laurencebarker/Aries-ATU/hardware/rev 5/rev 5 PCB modification 2.png

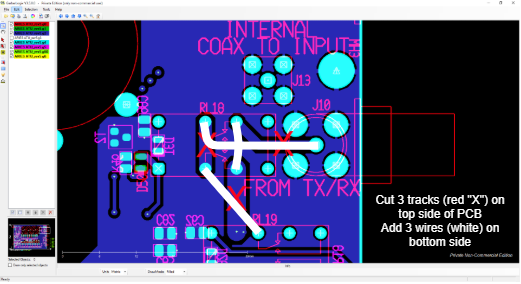
hardware/rev 5/rev 5 PCB modification 2.png
