laurencebarker/Aries-ATU/pictures/20201004_124850.jpg

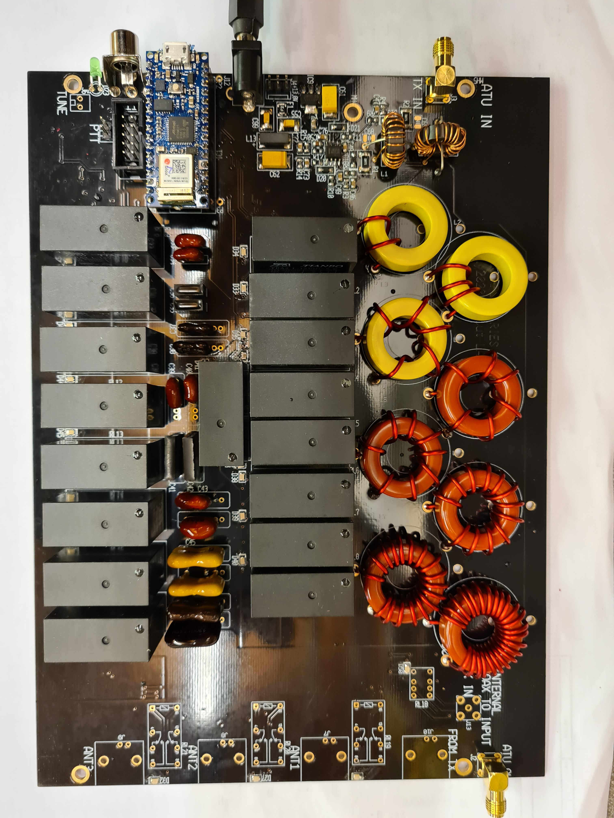
pictures/20201004_124850.jpg
