laurencebarker/Aries-ATU/README.md

# Aries ATU
 ARIES ATU for HPSDR project
