laurencebarker/Aries-ATU/documentation/Binocular core VSWR bridge.png

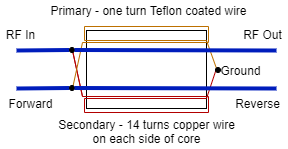
documentation/Binocular core VSWR bridge.png
