laurencebarker/Aries-ATU/hardware/rev 5/rev 5 PCB modification 1.png

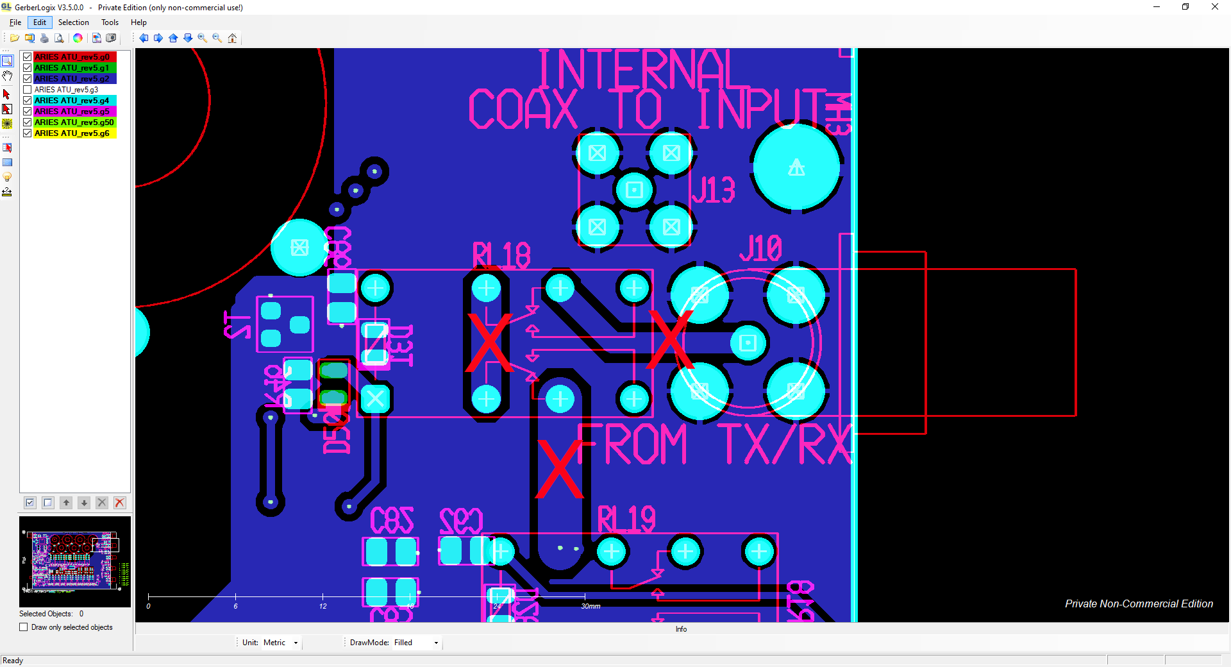
hardware/rev 5/rev 5 PCB modification 1.png
