laurencebarker/Aries-ATU/nextion display/crossed needle 200.png

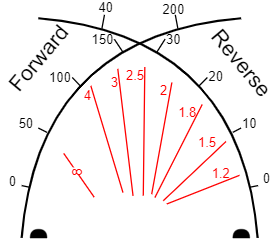
nextion display/crossed needle 200.png
