laurencebarker/Aries-ATU/nextion display/crossed needle-2000W.png

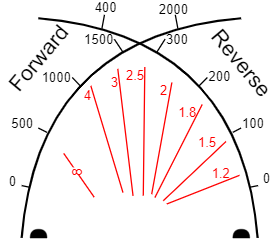
nextion display/crossed needle-2000W.png
