laurencebarker/Aries-ATU/nextion display/linear power meter-analogue meter 100.png

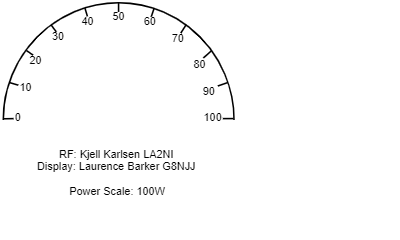
nextion display/linear power meter-analogue meter 100.png
