laurencebarker/Aries-ATU/nextion display/linear power meter-Analogue Meter 2000.png

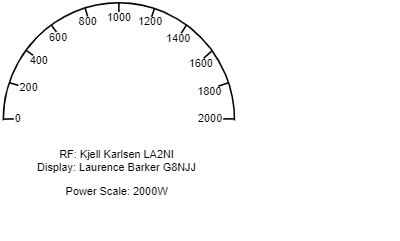
nextion display/linear power meter-Analogue Meter 2000.png
