laurencebarker/Aries-ATU/hardware/rev 5/Aries parts list rev 5.xlsx

Sheet: Embedded ATU
Qty | reference | type | part number | RS stock number
17 | RL1-RL17 | Relay | TIANBO TRA2 L-12VDC-S-Z | n/a
1 | IC1 | Arduino | Nano 33 IoT | n/a
2 | IC2, 3, 7 | Shift register | TPIC6B595 | 662-9203
1 | IC4 | op Amp | LM358BIDR SOIC | 689-6719
1 | IC5 | logic | 74HCT04D SOIC | 112-9988
1 | IC6 | regulator | LM1117S33CTR SOT223 | 197-7198
1 | IC8 | EEPROM | 24FC1026-I/SN SOIC | 823-3270
1 | IC9 | regulator | LM1117-5 SOT-223 | 535-8641
22 | D1-D17, D24-26, D51, D52 | diode | BAS16J 0805
4 | D18-21 | diode | IN5711W-7-F SOD-80_W
17 | D33-49 | LED | 0805 red | 654-5818
1 | D23 | LED | 3mm leaded green
52 | C1-C32, C46-49, C59-C60, C64-C67, C70- C76, C88, C90-91 | capacitor | 10nF 0805 50Vceramic
2 | C33-C34 | capacitor | 20pF mica
2 | C35-C36 | capacitor | 39pF mica
2 | C37-C38 | capacitor | 82pF mica
2 | C39-C40 | capacitor | 180pF mica
2 | C41-C42 | capacitor | 330pF mica
2 | C43-C44 | capacitor | 680pF mica
2 | C45, C56 | capacitor | 1300pF mica
2 | C57-C58 | capacitor | 2700pF mica
2 | C50, C51 | capacitor | 1uF 0805 25V ceramic
1 | C62 | capacitor | 100uF 10V tantalum 7.5x4.5mm
1 | C61 | capacitor | 15uF 35V tantalum 7.5x4.5mm
5 | C53, C55, C99, C101, C102 | capacitor | 10uF 0805 25V ceramic
5 | C63, C77, C89, C98, C100 | capacitor | 100nF 0805 50V ceramic
6 | R1, R2, R41-R44 | resistor | 100R 0.75W 2010 (5025M) | 198-8501
2 | R3, R4 | resistor | 100K 0805
10 | R5-R7, R22, R24, R25, R26, R45, R47, R48 | resistor | 10K 0805
3 | R8, R9, R23 | resistor | 1K 0805
2 | R10, R11 | resistor | 220K 0805
2 | R12, R13 | resistor | Dependent on full scale power required For 100W: 2K7 For 200W: 4K7 F0r 500W: 8K2 For 1000W: 12K For 2000W: 18K
2 | R14, R15 | resistor | 1K8 0805 (for all power scales)
17 | R19-21, R27-40 | resistor | 2K7 0805
1 | F1 | fuse | polysilicon 2.1A 1206 | 817-1668
2 | L3-L4 | toroid | T94-6
4 | L4-L8 | toroid | T94-2
1 | L9, L11 | toroid | BN-61-202
3 | L10, L12, L13 | ferrite bead | Fair-rite 2743021447 | 467-3365
2 | L19-L20 | ferrite bead | 0805
2 | J2, J3 | SMA rt angle |  | 616-3400 | DNI
2 | J14, J16 | BNC rt angle | TYCO 5-1634556-0 | 616-3084
1 | J12 | connector | 2.1mm 12V power | 448-376
1 | J4 | connector | 3 pin 0.1" pitch header
1 | J11 | connector | phono PCB mtg
1 | J1 | connector | header 2x5 pin 0.1" pitch |  | DNI
2 | J15, J18 | connector | header 4 pin 0.1" pitch
1 | J19 | connector | header 5 pin 0.1" pitch
3 | J5, J6, J17 | connector | header 2 pin 0.1" pitch |  | DNI
1 | L22 | wire | jumper pin 1-2
DNI=do not insert this component!
Inductor windings:
L1 | 2T 18SWG wound on 6.5mm drill bit, 0.15" length
L2 | 3T 18SWG wound on 6.5mm drill bit, 0.2" length
L3 | T94-6 (yellow) | 4T 18 SWG
L4 | T94-6 (yellow) | 5T 18 SWG
L5 | T94-2 (red) | 7T 18 SWG
L6 | T94-2 (red) | 9T 18SWG
L7 | T94-2 (red) | 13T 18SWG
L8 | T94-2 (red) | 19T 18SWG
VSWR bridge | BN-61-202 | primary: 1T 22 SWG through centre
 |  | secondary: 14T 26 SWG wound around the sides of the core
SK17 | add a jumper on SK17 for "standalone" ATU mode
The VSWR bridge is now a binocular core using a BN-61-202 core, 14 turns

Sheet: Standalone ATU
Qty | reference | type | part number | RS stock number
2 | J14, J16 |  |  |  | DNI
2 | L14-15 | ferrite bead | Fair-rite 2743021447 | 467-3365
3 | L16-L18 | ferrite bead | 0805 size, 100 ohm@10MHz
2 | J2, J13 | SMA vert
4 | J7-J10 | BNC rt angle |  | 616-3084
4 | D28-D31 | Diode | BAS16J 0805
11 | C54, C79, C84, C86, C87, C92-97 | capacitor | 10nF 0805 50Vceramic
6 | C78, C80-83, C85 | capacitor | 100nF 0805 ceramic
1 | T2 | FET | 2N7002K-T/R
4 | R16-18, R46 | Resistor | 2K7 0603
4 | RL18-21 | Relay | Omron G6A-274P | Mouser 653-G6A-274P-DC12
4 | D22, D27, D32, D50 | LED | red 0805
1 | J2-J3 | Cable | SMA-SMA
These components are in addition to those loaded for embedded use in the Andromeda radio
