laurencebarker/Aries-ATU/hardware/protection board/protection board parts list.xlsx

Protection Board
Qty | reference | type | part number | RS stock number
 | R6, R7, R8, R18,R19, R20, R22 | 1K 0603
 | R5, R21, R23 | 10K 0603
 | R1, R2, R3, R4, R9, R10, R11, R16, R17 | 2K2 0603
 | R24 | 22K 0603
 | R12, R13, R14, R15 | 1K potentiometer
 | C1, C2, C5, C6, C8, C12, C13, C14, C16, C17, C18, C19, C20, C21, C22, C23 | 100nF 0805
 | C4, C7, C9, C10 | 1uF 0805
 | C3, C11 | 10uF 0805
1 | D1 | bAS16J
6 | D2-D7 | S1M
2 | T1, T2 | 2N7002A
1 | U1 | LM339
1 | IC1 | MCP23017
1 | U2 | 74HC02SO
1 | U3 | 74HC21SO
1 | U4 | LM1117-3V3
1 | ENC1 | Encoder
