laurencebarker/Aries-ATU/documentation/atu toroids.xlsx

Sheet: 1st prototype
 |  | T80-6 |  | T80-10 |  | T80-2 |  | T68-2 |  | T68-6
 | target inductance | turns | actual | turns | actual | turns | actual | turns | actual | turns | actual
L1 | 0.04 | 3 | 0.04 | 4 | 0.05 | 3 | 0.05 |  |  | 3 | 0.04
L2 | 0.08 | 4 | 0.07 | 5 | 0.08 | 4 | 0.09 |  |  | 4 | 0.08
L3 | 0.16 | 6 | 0.16 | 7 | 0.16 | 0.14 | 5 |  |  | 6 | 0.17
L4 | 0.32 | 8 | 0.29 | 10 | 0.32 | 0.35 | 8 |  |  | 8 | 0.3
L5 | 0.64 | 12 | 0.65 | 14 | 0.63 | 0.67 | 11 |  |  | 12 | 0.68
L6 | 1.28 | 17 | 1.3 | 20 | 1.28 | 1.24 | 15 | 15 | 1.28
L7 | 2.56 | 24 | 2.59 | 28 | 2.51 | 2.66 | 22 | 21 | 2.51
L8 | 5.12 | 34 | 5.2 | 40 | 5.12 | 5.29 | 31 | 30 | 5.13
 | power handling?
 | AT11 values | T106-2
 | target inductance | turns | actual
 | 0.08 | 1 | 0.01
 | 0.16 | 2 | 0.05
 | 0.31 | 3 | 0.12
 | 0.62 | 4 | 0.22
 | 1.25 | 7 | 0.66
 | 2.5 | 11 | 1.63
 | 5 | 17 | 3.9
 | 10 | 25 | 8.44
 | www.changpuak.ch
Capacitors
comp | value (pF) | total value (pF)
C33, C34 | 18 | 9
C35, C36 | 39 | 19.5
C38, C38 | 82 | 41
C39, C40 | 150 | 75
C41, C42 | 330 | 165
C43, C44 | 680 | 340
C45, C56 | 1500 | 750
C57, C58 | 3300 | 1650

Sheet: Revised
target inductance uH | Toroid | Al | Calc Turns | Actual turns | Achieved inductance uH | Measured inductance uH
0.04 | T68-2 | 57 | 2.6 | 1 | 0.006
0.08 | T68-2 | 57 | 3.7 | 2 | 0.02
0.18 | T68-2 | 57 | 5.6 | 4 | 0.09
0.312 | T106-2 | 135 | 4.8 | 4 | 0.22
0.625 | T106-2 | 135 | 6.8 | 6 | 0.49
1.25 | T106-2 | 135 | 9.6 | 9 | 1.09
2.5 | T106-2 | 135 | 13.6 | 13 | 2.28
5 | T106-2 | 135 | 19.2 | 19 | 4.87
Toroid | Al
T50-2 | 49
T50-6 | 40
T68-2 | 57
T68-6 | 47
T80-2 | 55
T80-6 | 45
T94-2 | 84
T94-6 | 70
T106-2 | 135
T106-6 | 116
Capacitors
comp | value (pF) | total value (pF)
C33, C34 | 18 | 9
C35, C36 | 39 | 19.5
C38, C38 | 82 | 41
C39, C40 | 150 | 75
C41, C42 | 330 | 165
C43, C44 | 680 | 340
C45, C56 | 1500 | 750
C57, C58 | 3300 | 1650

Sheet: prototype 2 revised again
target inductance uH | Toroid | Al | Calc Turns | Actual turns | Achieved inductance uH
0.023 | T94-6 | 70 | 1.8 | 1 | 0.007 | try 2T 0.3" dia 0.15" length
0.047 | T94-6 | 70 | 2.6 | 2 | 0.03 | try 3T 0.3" dia 0.2" length
0.094 | T94-6 | 70 | 3.7 | 4 | 0.11
0.188 | T94-6 | 70 | 5.2 | 5 | 0.17
0.375 | T94-2 | 84 | 6.7 | 7 | 0.41
0.75 | T94-2 | 84 | 9.4 | 9 | 0.68
1.5 | T94-2 | 84 | 13.4 | 13 | 1.42
3 | T94-2 | 84 | 18.9 | 19 | 3.03
Toroid | Al
T50-2 | 49
T50-6 | 40
T68-2 | 57
T68-6 | 47
T80-2 | 55
T80-6 | 45
T94-2 | 84
T94-6 | 70
T106-2 | 135
T106-6 | 116
Capacitors
component | Target | value (pF) | combined value (pF)
C33, C34 | 21.1 | 20 | 10 | non-E12
C35, C36 | 42.2 | 39 | 19.5
C38, C38 | 84.4 | 82 | 41
C39, C40 | 168.8 | 180 | 90
C41, C42 | 337.5 | 330 | 165
C43, C44 | 675 | 680 | 340
C45, C56 | 1350 | 1300 | 650 | non-E12
C57, C58 | 2700 | 2700 | 1350

Sheet: prototype 2
target inductance uH | Toroid | Al | Calc Turns | Actual turns | Achieved inductance uH
0.04 | T94-6 | 70 | 2.4 | 2 | 0.028
0.08 | T94-6 | 70 | 3.4 | 3 | 0.06
0.18 | T94-6 | 70 | 5.1 | 5 | 0.17
0.312 | T94-2 | 84 | 6.1 | 6 | 0.30
0.625 | T94-2 | 84 | 8.6 | 8 | 0.54
1.25 | T94-2 | 84 | 12.2 | 12 | 1.21
2.5 | T94-2 | 84 | 17.3 | 17 | 2.43
5 | T94-2 | 84 | 24.4 | 24 | 4.84
Toroid | Al
T50-2 | 49
T50-6 | 40
T68-2 | 57
T68-6 | 47
T80-2 | 55
T80-6 | 45
T94-2 | 84
T94-6 | 70
T106-2 | 135
T106-6 | 116
Capacitors
comp | value (pF) | total value (pF)
C33, C34 | 18 | 9
C35, C36 | 39 | 19.5
C38, C38 | 82 | 41
C39, C40 | 150 | 75
C41, C42 | 330 | 165
C43, C44 | 680 | 340
C45, C56 | 1500 | 750
C57, C58 | 3300 | 1650
