laurencebarker/Aries-ATU/measurements/16112020 Aries mk2 tuning solutions.xlsx

Sheet: Tuning Solutions 5uH largest
17 October 2020 Aries mk2 test results. Largest inductor 5uH largest capacitor 1650pF
Frequency | Antenna analyser |  |  |  | algorithm
1.9 MHz | Z sw | L | C | VSWR | Z sw | L | C | VSWR
8:1 Low | L | 29 | 255 | 1.7
5:1 | L | 31 | 240 | 1.4
4:1 | L | 37 | 208 | 1.4
3:1 | L | 39 | 180 | 1.3
2:1 | L | 44 | 128 | 1.3
1:1 | L | 0 | 0 | 1.0
2:1 High | H | 78 | 53 | 1.5
3:1 | H | 128 | 53 | 1.5
4:1 | H | 152 | 46 | 1.5
5:1 | H | 182 | 42 | 1.5
8:1 | H | 255 | 32 | 1.6
Antenna | L | 160 | 71 | 2.4
1st search |  | Lo Z; L=32; C=0-255 step 24
 |  | Lo Z; C=32; L=0-255 step 24 |  |  |  |  |  | TUNED ANTENNA!
 |  | Hi Z; L=32; C=0-255 step 24
 |  | Hi Z; C=32; L=0-255 step 24
2nd search |  | same Z; swap L/C; 0-255 step 24
Frequency | Antenna analyser |  |  |  | algorithm
3.65 MHz | Z sw | L | C | VSWR | Z sw | L | C | VSWR
8:1 Low | L | 5 | 128 | 1.4
5:1 | L | 8 | 127 | 1.3
4:1 | L | 9 | 109 | 1.3
3:1 | L | 16 | 93 | 1.3
2:1 | L | 11 | 64 | 1.3
1:1 | L | 0 | 8 | 1.0
2:1 High | H | 48 | 26 | 1.3
3:1 | H | 64 | 24 | 1.3
4:1 | H | 76 | 19 | 1.3
5:1 | H | 96 | 16 | 1.3
8:1 | H | 120 | 12 | 1.4
Antenna | L | 33 | 138 | 1.4
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
