laurencebarker/Aries-ATU/measurements/24032020 Aries mk1 test results.xlsx

Sheet: VSWR Bridge
Aries VSWR tests
VSWR bridge alone not connected to L/C and relays
 |  | multimeter |  |  | Arduino ADC measurements
Load ohms | expected VSWR | Vf | Vr | Calc VSWR | Vf (ADC) | Vr (ADC) | dig VSWR
12.5 | 4:1 | 0.793 | 0.46 | 3.8 | 998 | 578 | 3.8
16.7 | 3:1 | 0.814 | 0.388 | 2.8 | 1033 | 496 | 2.8
25 | 2:1 | 0.85 | 0.268 | 1.9 | 1083 | 347 | 1.9
50 | 1:1 | 0.939 | 0 | 1.0 | 1199 | 11 | 1.0
100 | 2:1 | 1.057 | 0.315 | 1.8 | 1326 | 400 | 1.9
150 | 3:1 | 1.115 | 0.535 | 2.8 | 1397 | 669 | 2.8
200 | 4:1 | 1.155 | 0.663 | 3.7 | 1447 | 839 | 3.8
VSWR bridge connected to relays and L/C
 |  | multimeter |  |  | Arduino ADC measurements
Load ohms | expected VSWR | Vf | Vr | Calc VSWR | Vf (ADC) | Vr (ADC) | dig VSWR
12.5 | 4:1 | 0.716 | 0.384 | 3.3 | 914 | 493 | 3.3
16.7 | 3:1 | 0.735 | 0.31 | 2.5 | 932 | 396 | 2.5
25 | 2:1 | 0.769 | 0.178 | 1.6 | 975 | 231 | 1.6
50 | 1:1 | 0.853 | 0.086 | 1.2 | 1084 | 113 | 1.2
100 | 2:1 | 0.972 | 0.485 | 3.0 | 1235 | 620 | 3.0
150 | 3:1 | 1.002 | 0.735 | 6.5 | 1315 | 960 | 6.4
200 | 4:1 | 1.088 | 0.884 | 9.7 | 1366 | 1105 | 9.5
VSWR bridge connected to relays and L/C, RL1 issue resolved
 |  | multimeter
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
