laurencebarker/Aries-ATU/documentation/test loads.xlsx

Zo | 50 | ohms
Load |  | Resistance | Made from | qty
8:1 L | 8 | 6.25 | 22R// 18R // 18R | 3
5:1 | 5 | 10 | 22R // 18R | 2
4:1 | 4 | 12.5 | 22R//27R | 2
3:1 | 3 | 16.7 | 33R//33R | 2
2:1 | 2 | 25 | 4x100R parallel | 4
1:1 | 1 | 50 | 100R // 100R | 2
2:1 | 2 | 100 | 180R // 220R | 2
3:1 | 3 | 150 | 330R // 270R | 2
4:1 | 4 | 200 | 100R + 100R | 2
5:1 | 5 | 250 | 100R + 150R | 2
8:1 | 8 | 400 | 270R + 220R | 2
 |  |  |  | 25
resistors needed
18R | 3
22R | 3
27R | 1
33R | 2
100R | 9
150R | 1
180R | 1
220R | 2
270R | 2
330R | 1
 | 25
parallel value calculator
R1 | 33
R2 | 33
parallel | 16.5
