laurencebarker/Aries-ATU/hardware/protection board/PA Protection Board.pdf

- R24 22K

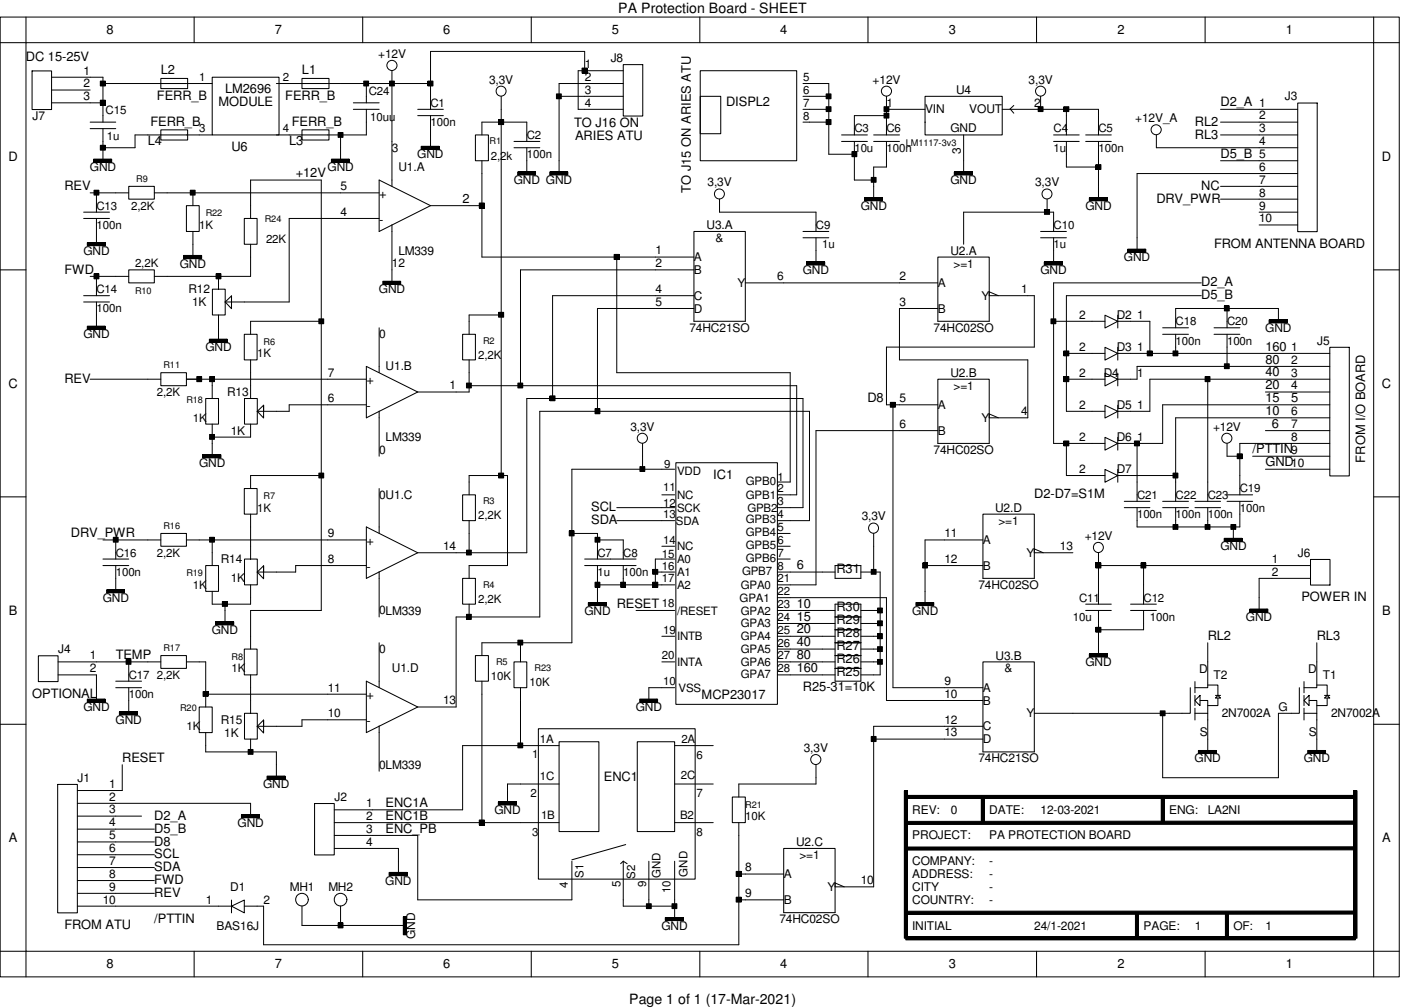
[picture p25: page 1]

PA Protection Board - SHEET

TO J15 ON ARIES ATU TO J16 ON ARIES ATU
