laurencebarker/Aries-ATU/hardware/rev 5/ARIES ATU_rev5_28_01_21.pdf

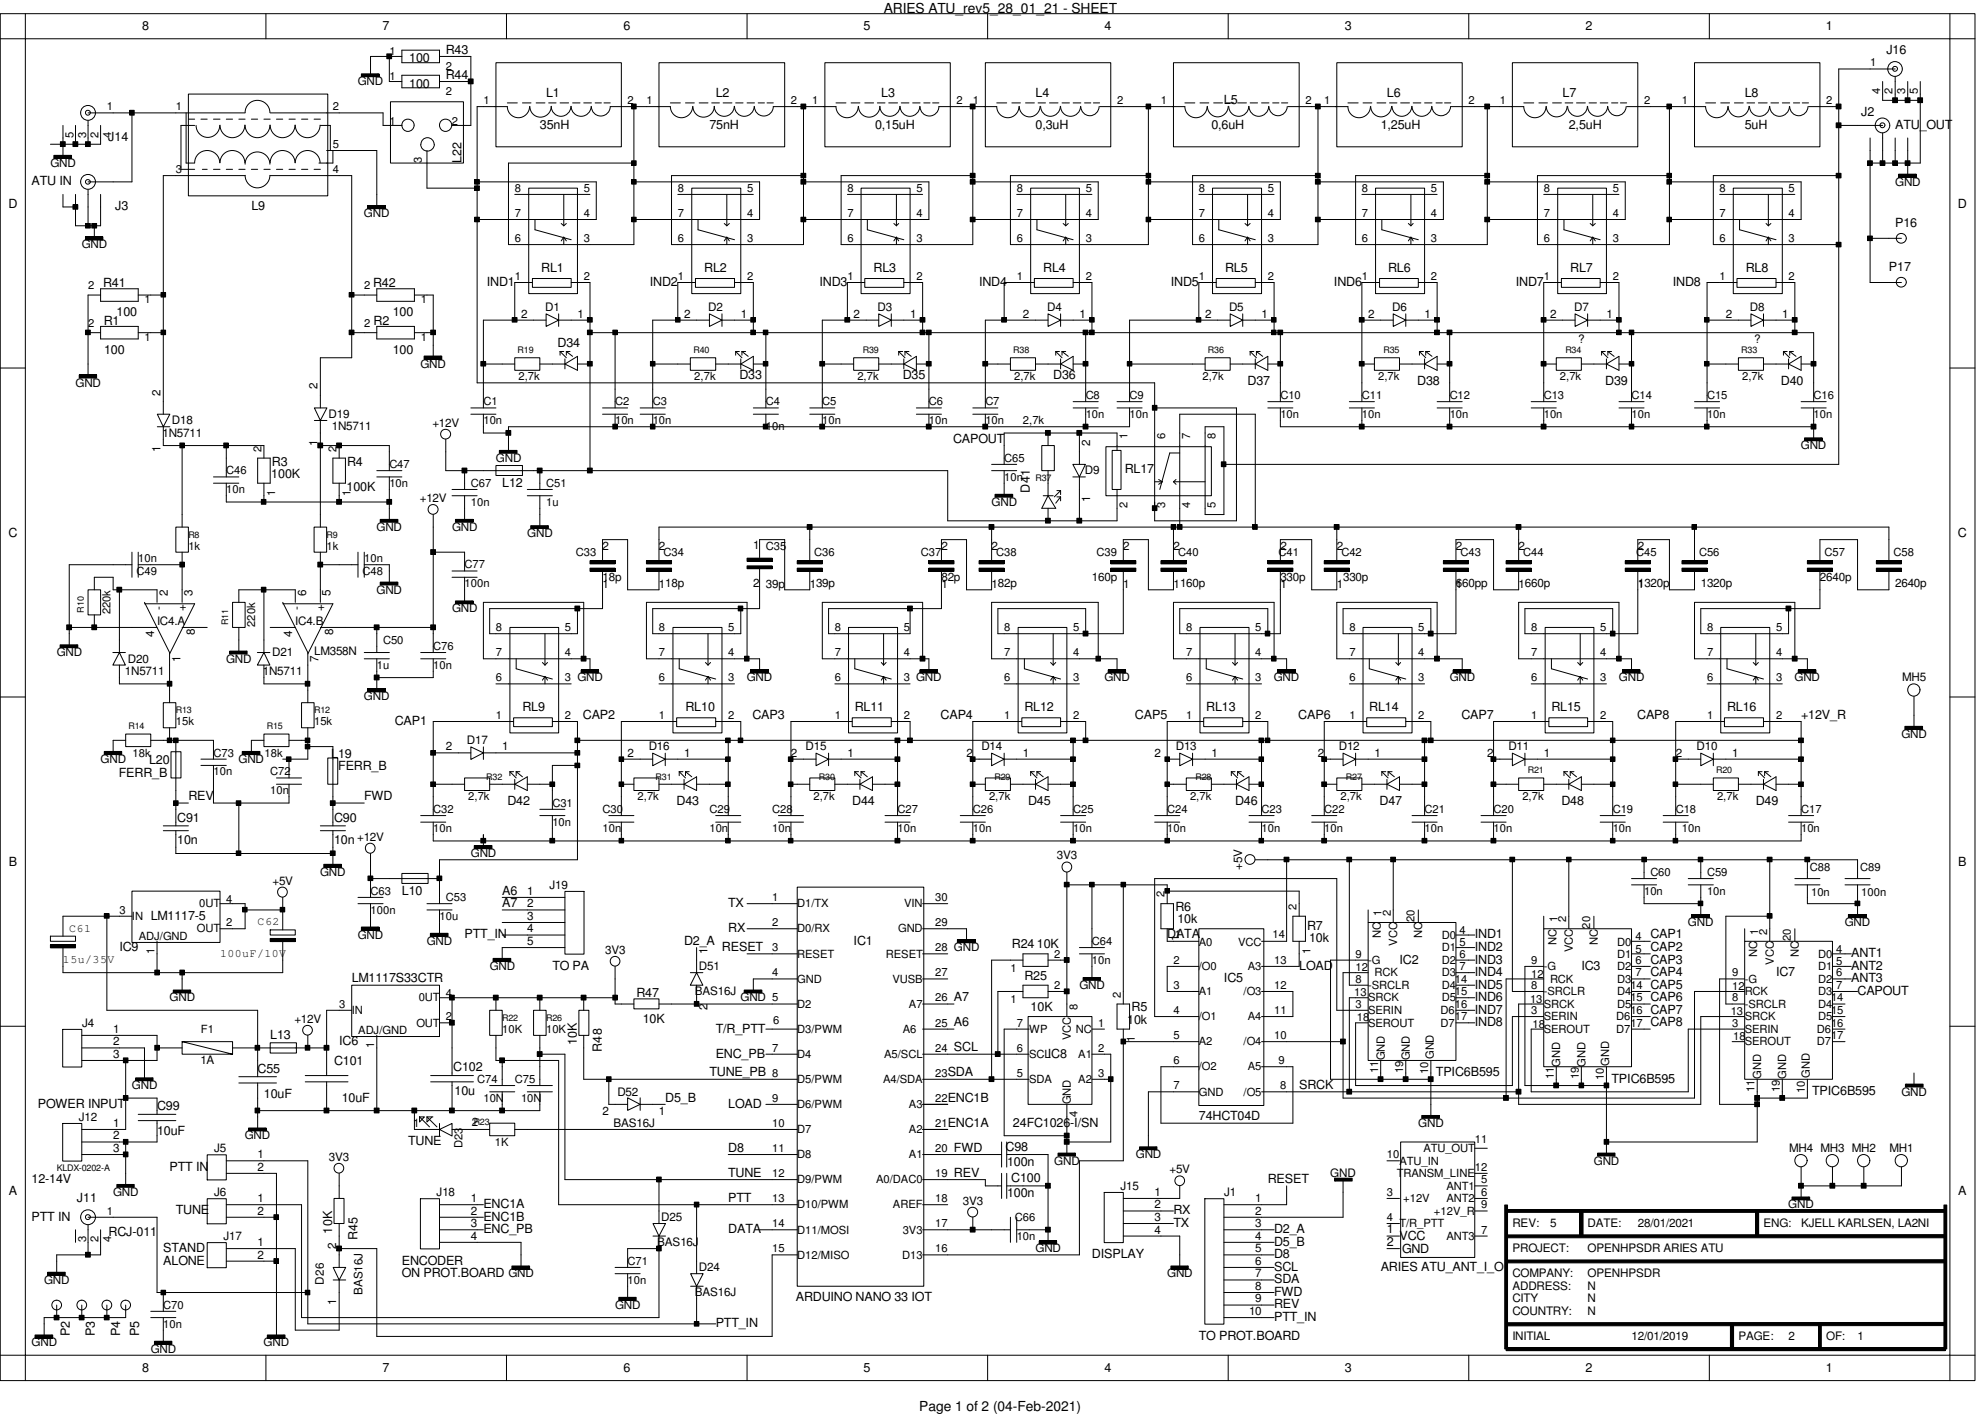
[picture p26: page 1]

# ARIES ATU_rev5_28_01_21 - SHEET

D | D

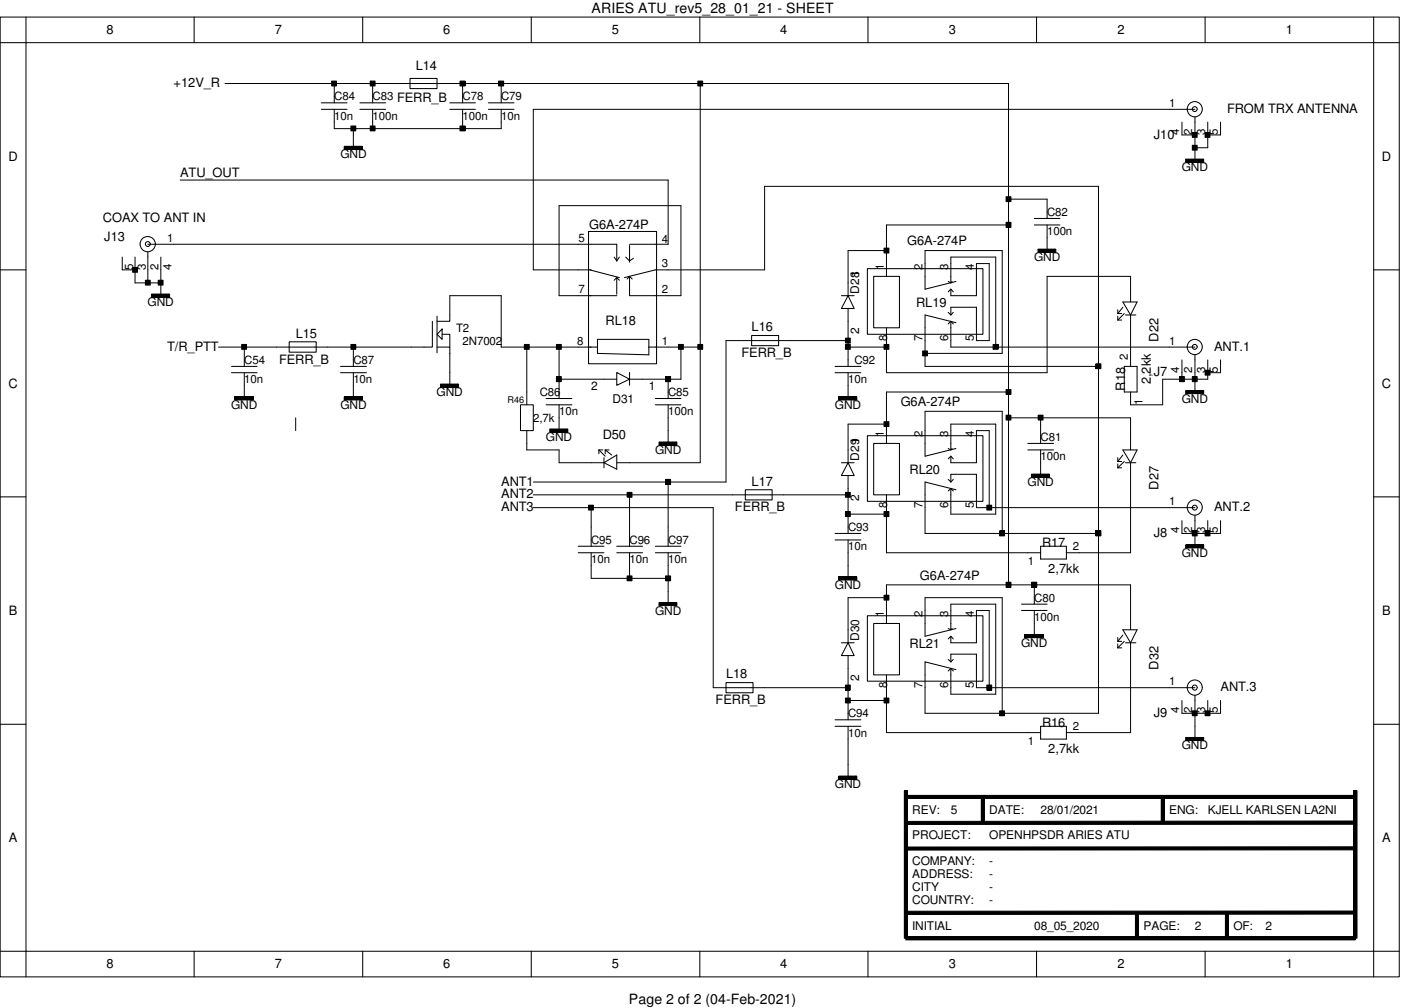
[picture p27: page 2]

COAX TO ANT IN
