laurencebarker/Aries-ATU/hardware/rev 5/ARIES ATU_rev5.pdf

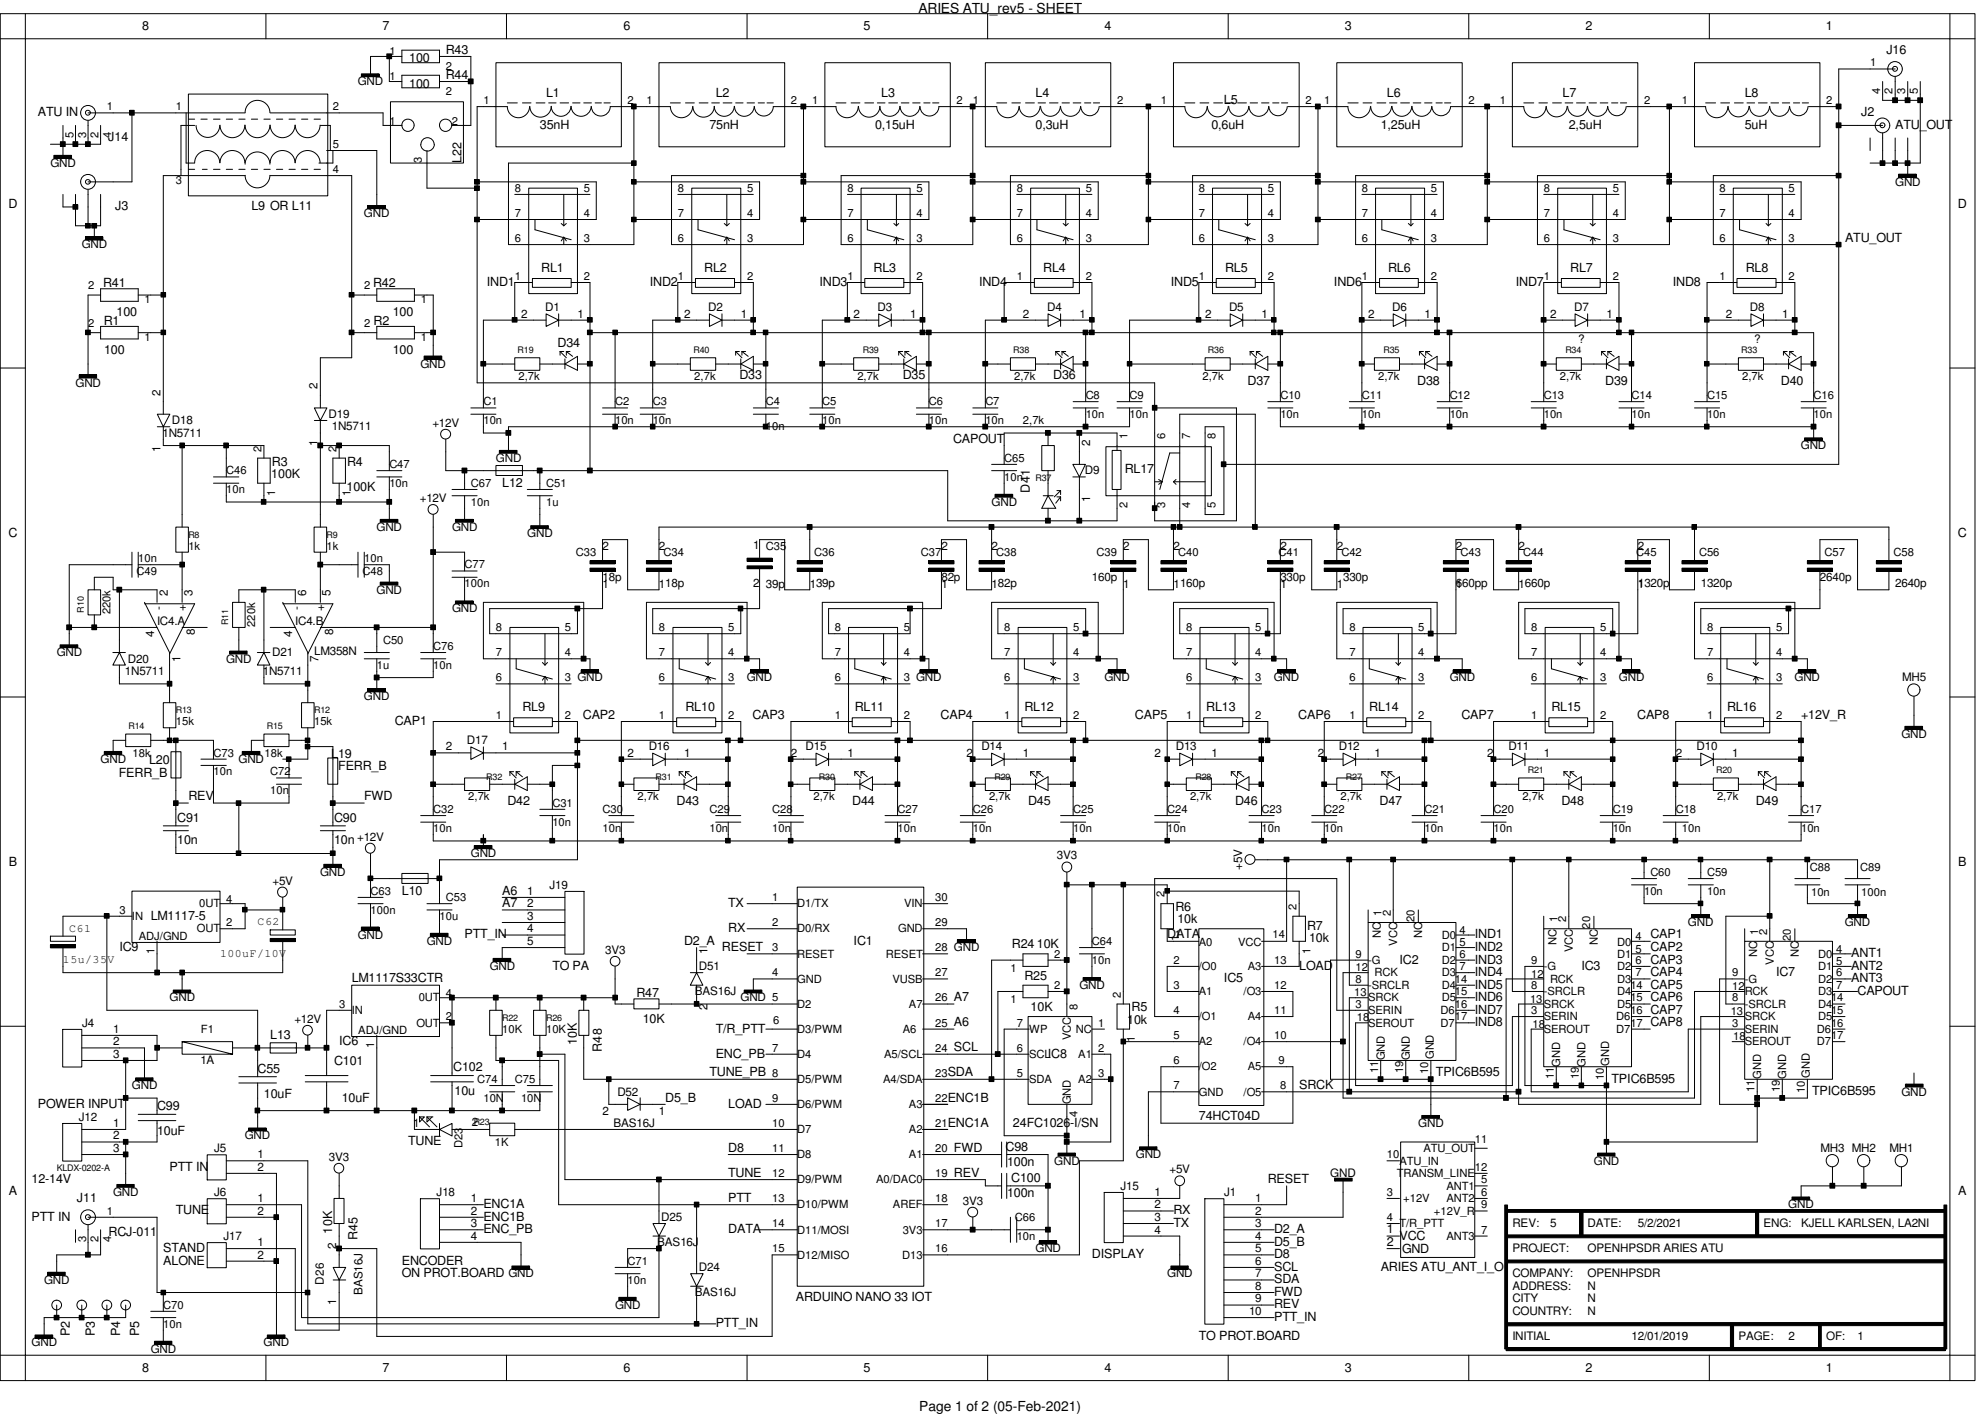
[picture p28: page 1]

# ARIES ATU_rev5 - SHEET

D | D

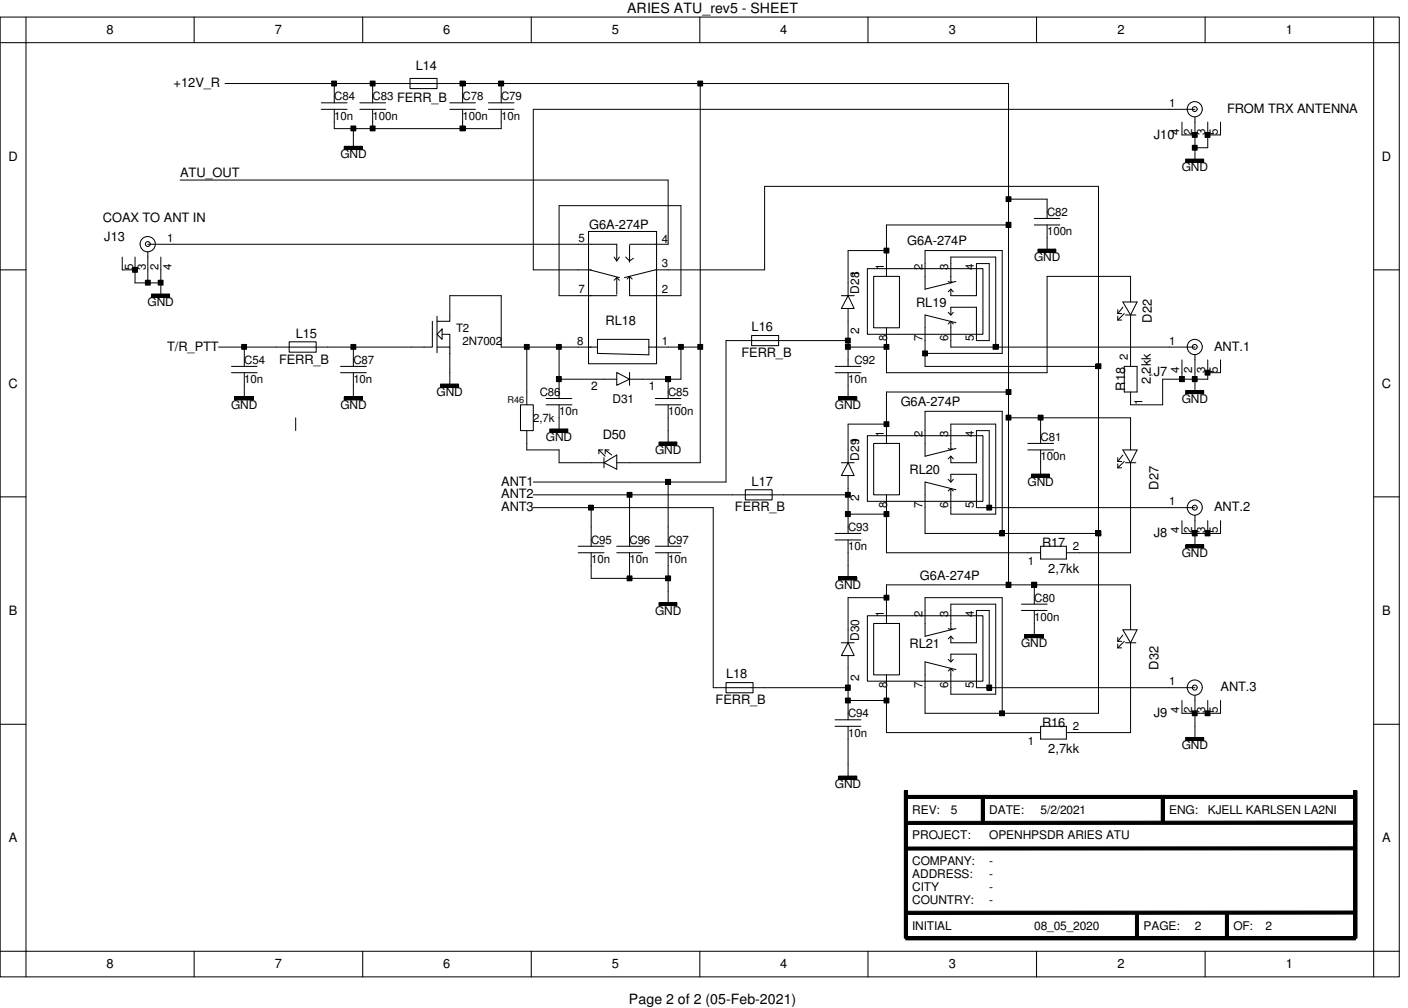
[picture p29: page 2]

COAX TO ANT IN
