laurencebarker/Aries-ATU/hardware/rev 4/ARIES ATU_rev4_18_11_20.pdf

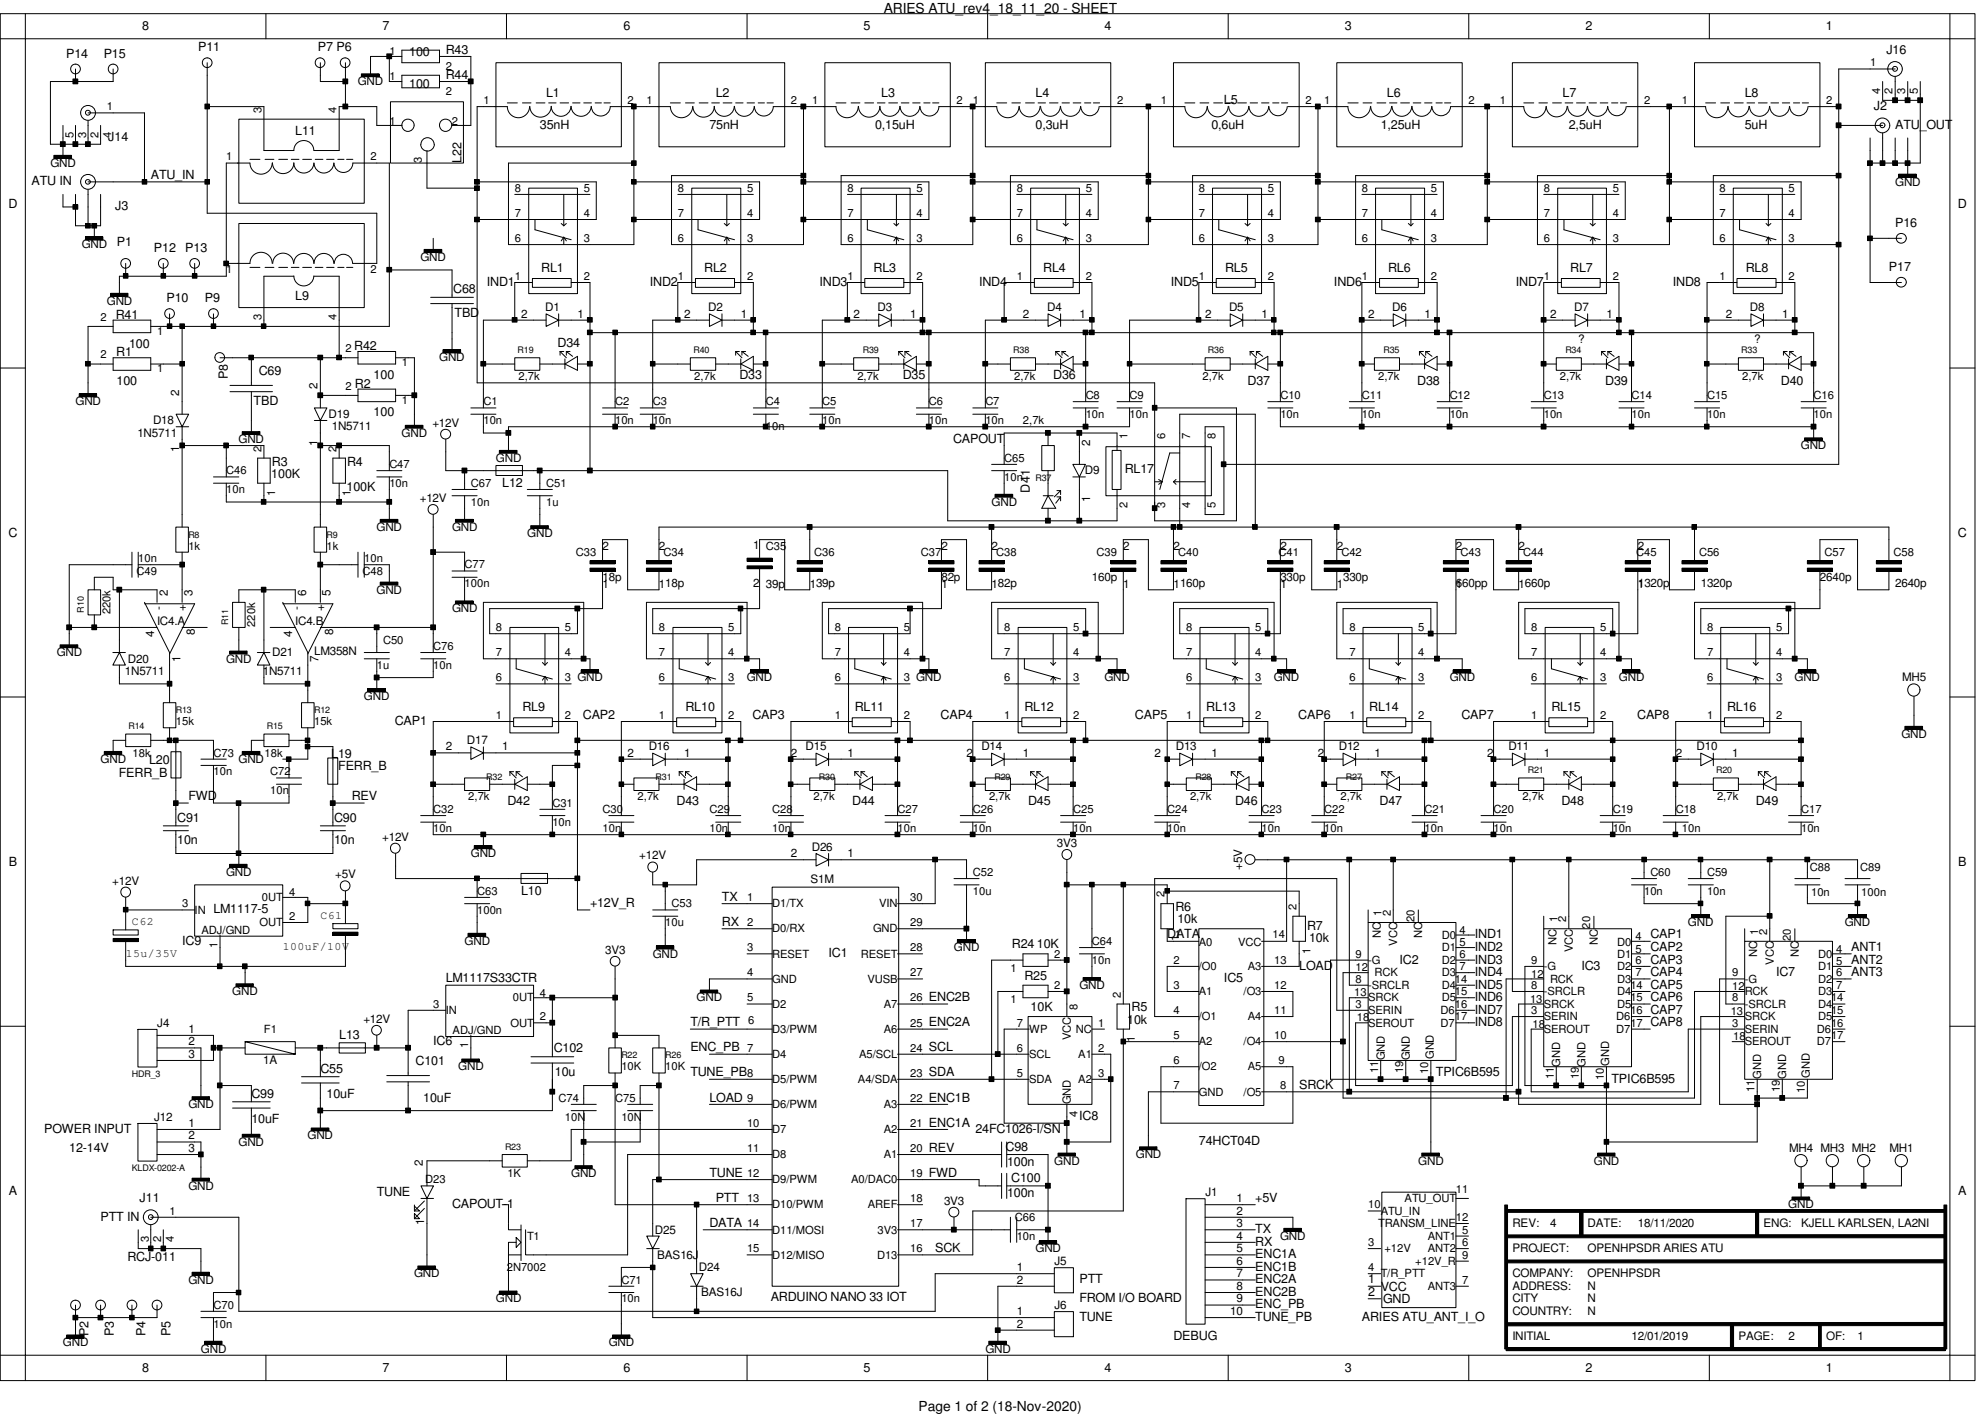
[picture p32: page 1]

INITIAL 12/01/2019 | PAGE: 2 | OF: 1

# ARIES ATU_rev4_18_11_20 - SHEET

D | D

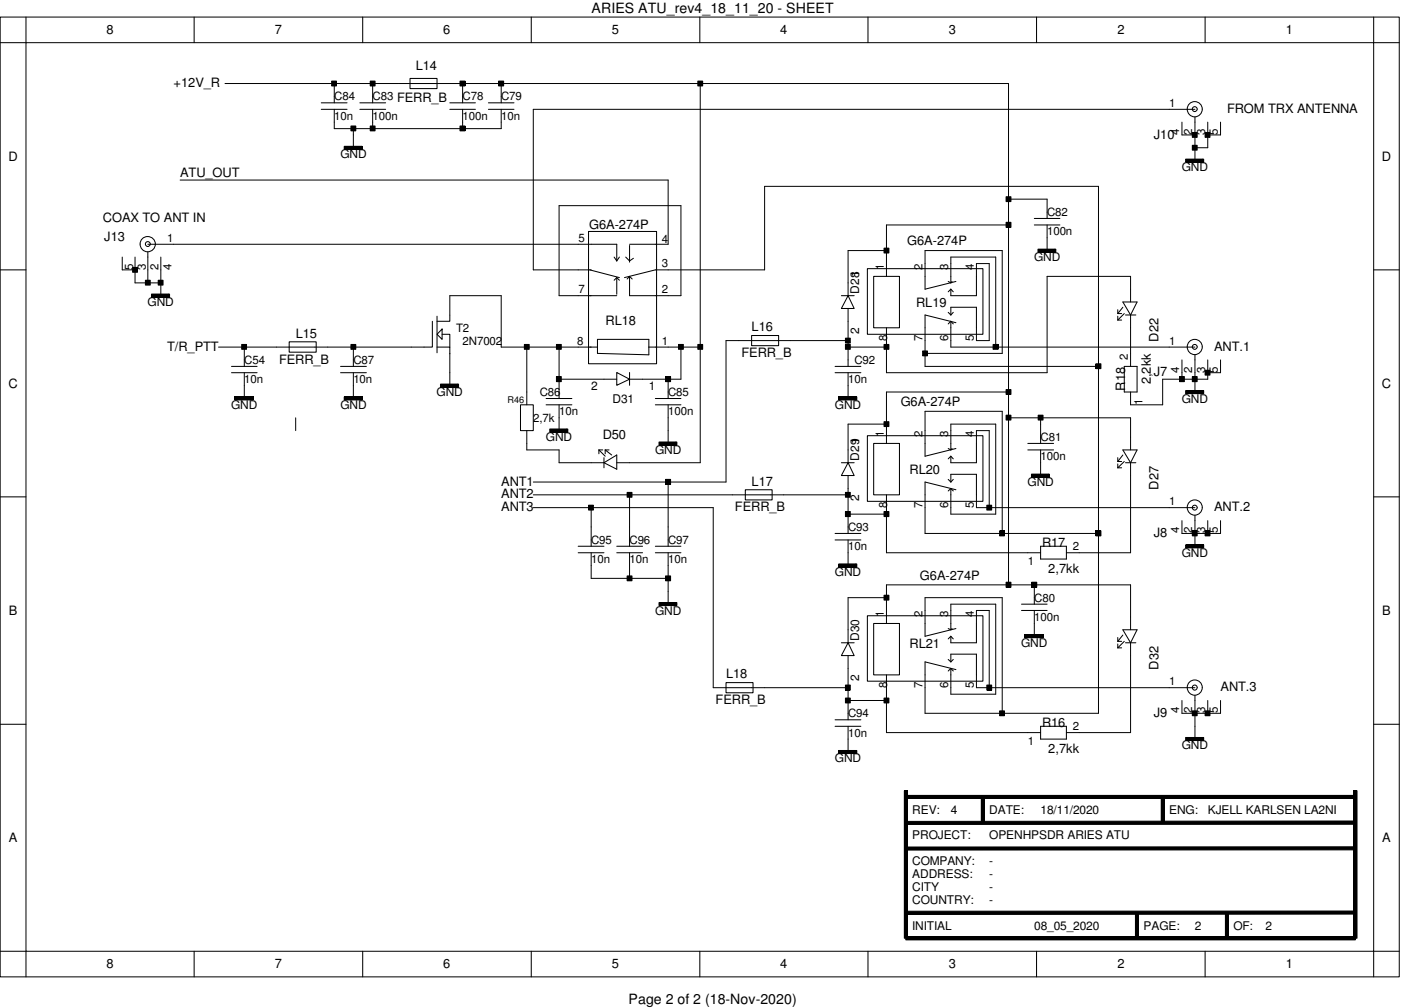
[picture p33: page 2]

COAX TO ANT IN
