laurencebarker/Aries-ATU/hardware/rev 4/ARIES ATU_rev4_20_11_20.pdf

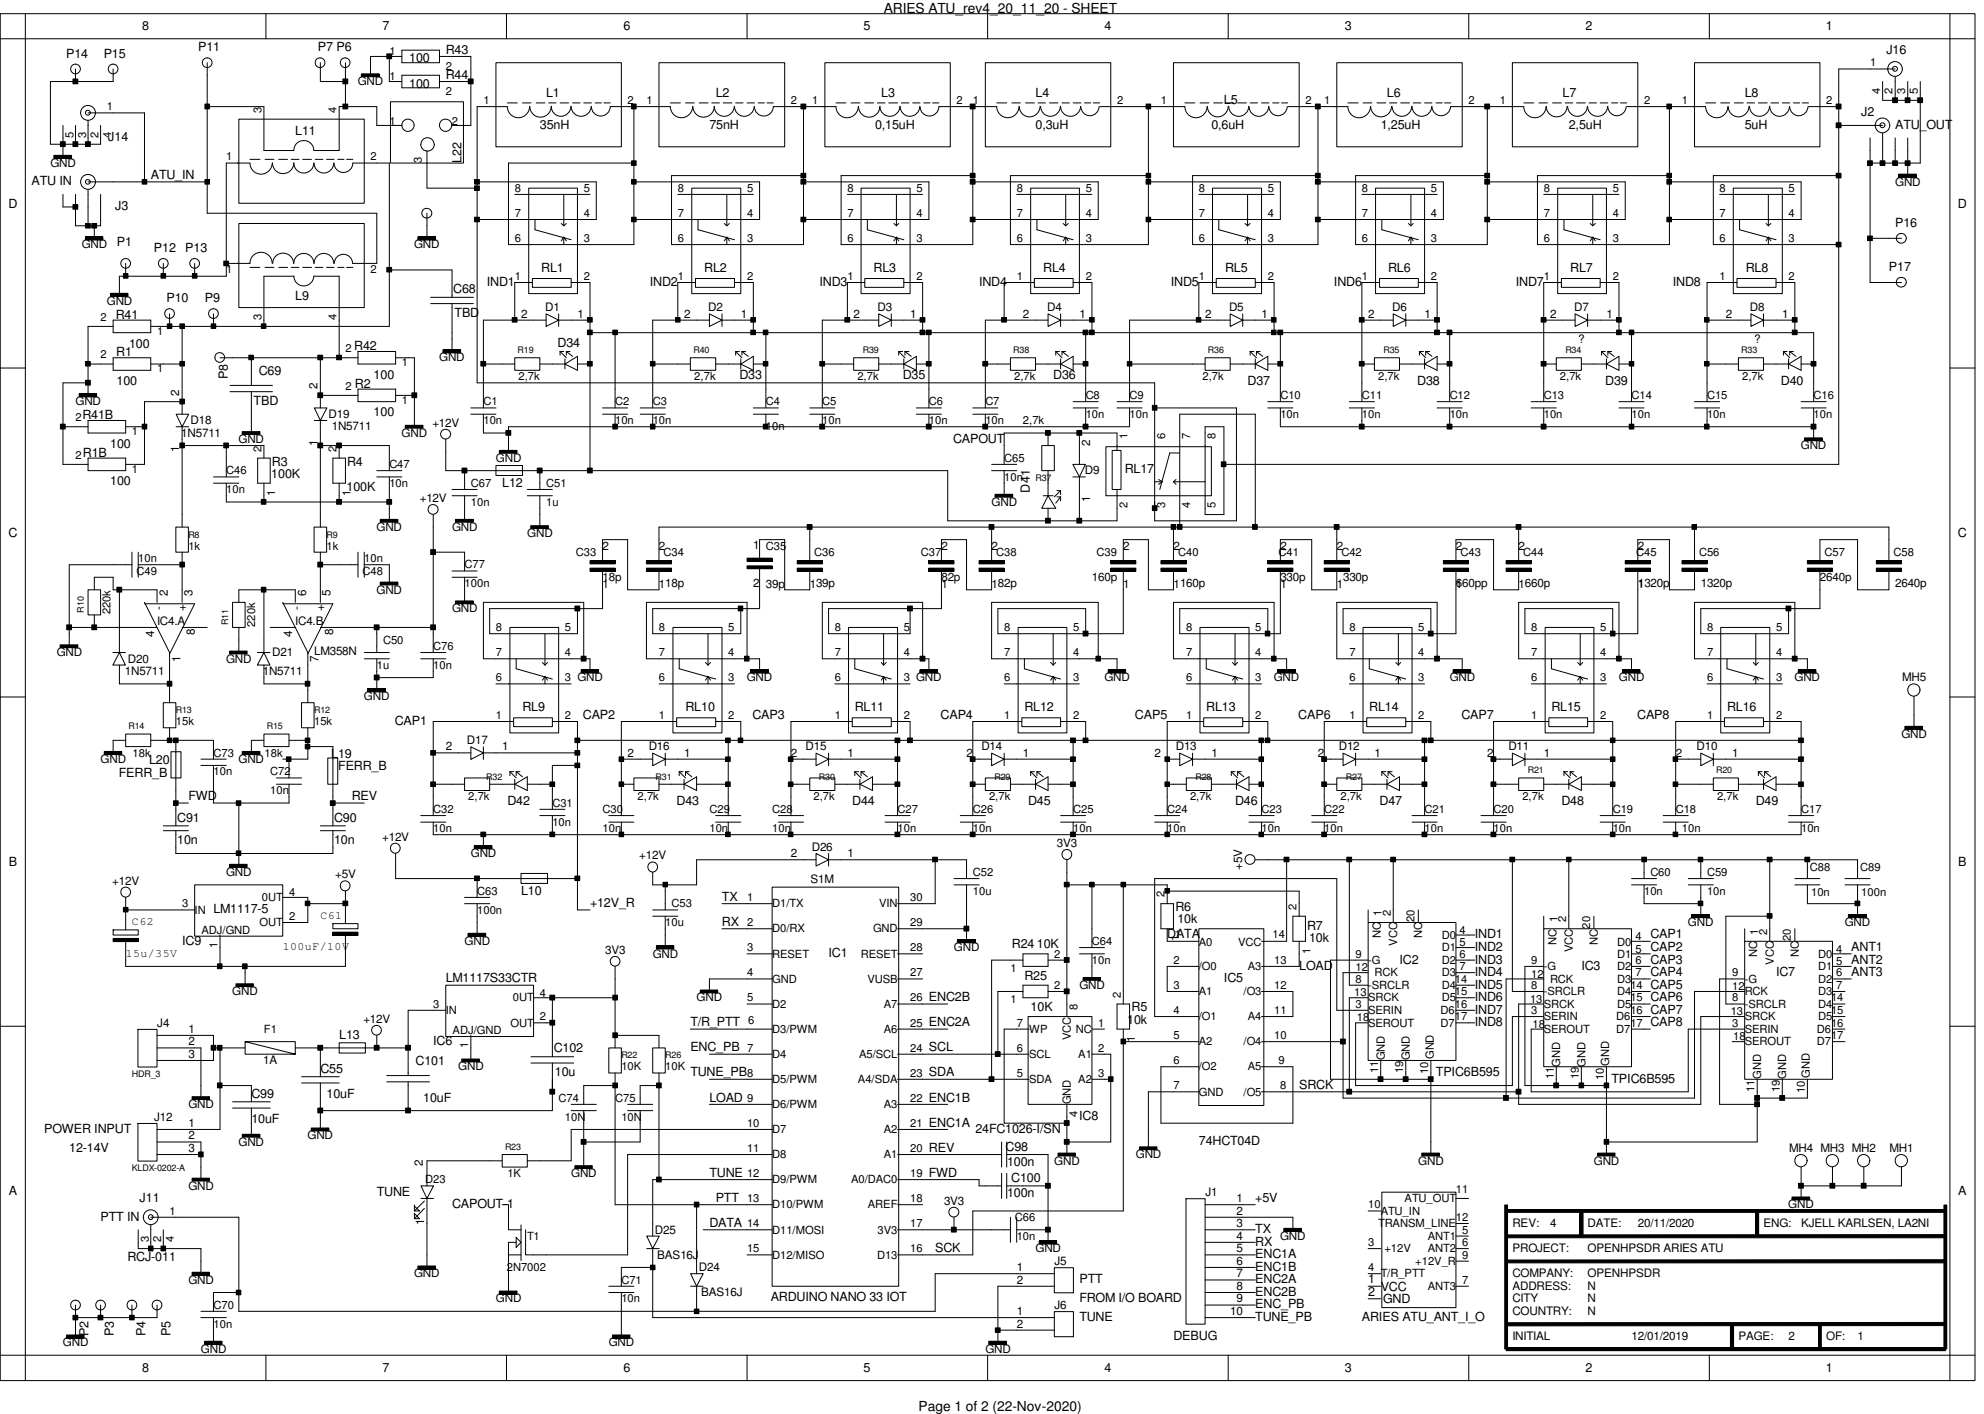
[picture p34: page 1]

INITIAL 12/01/2019 | PAGE: 2 | OF: 1

# ARIES ATU_rev4_20_11_20 - SHEET

D | D

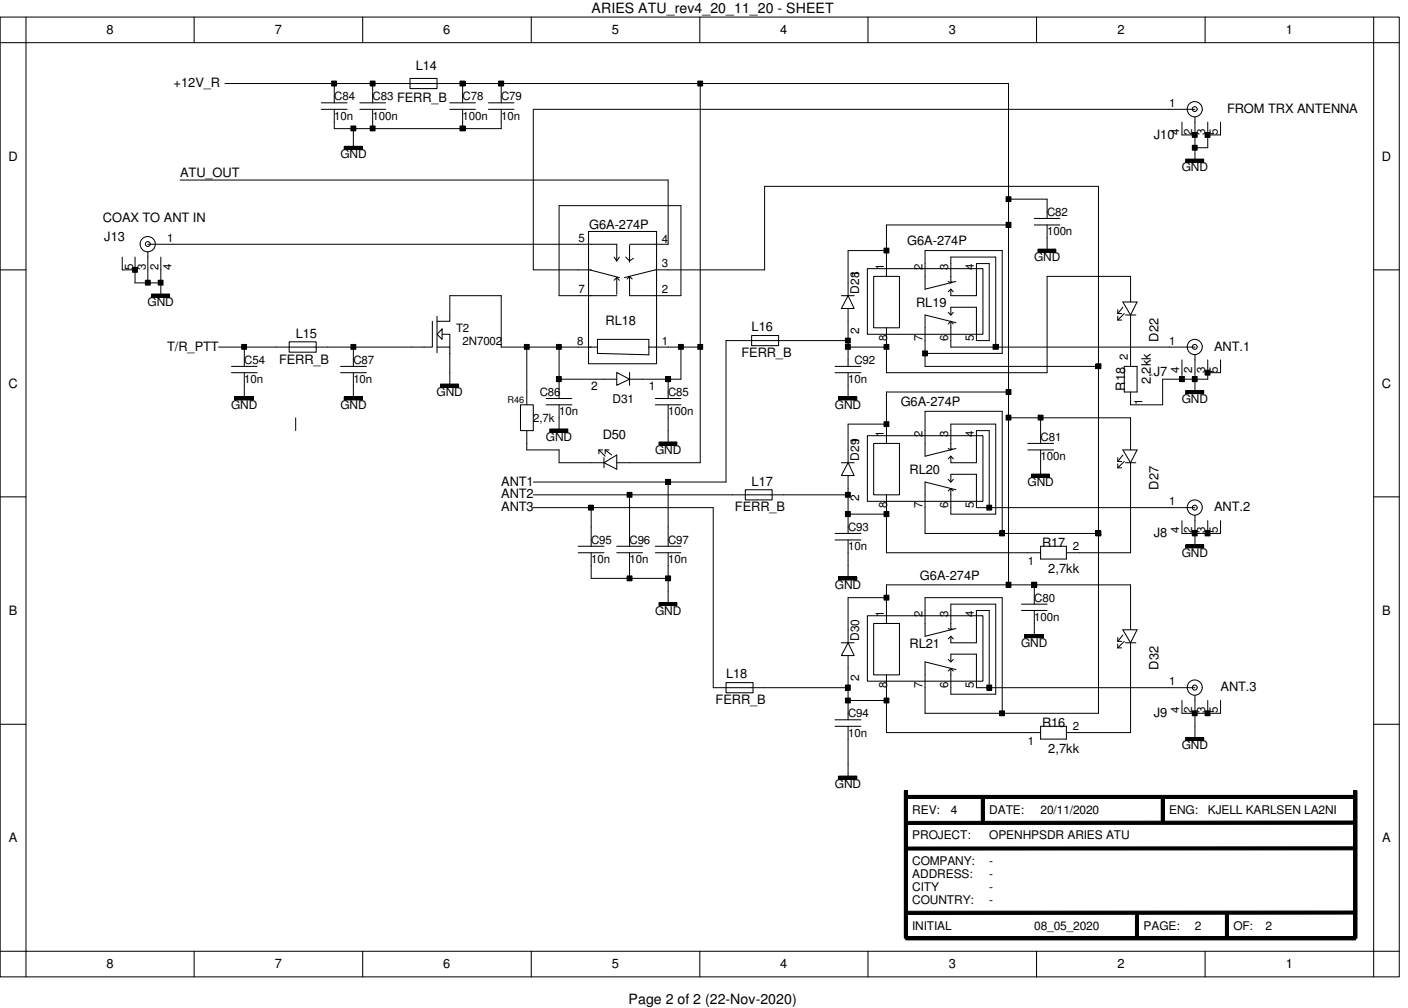
[picture p35: page 2]

COAX TO ANT IN
