laurencebarker/Aries-ATU/hardware/rev 4/ARIES Notation Bott.pdf

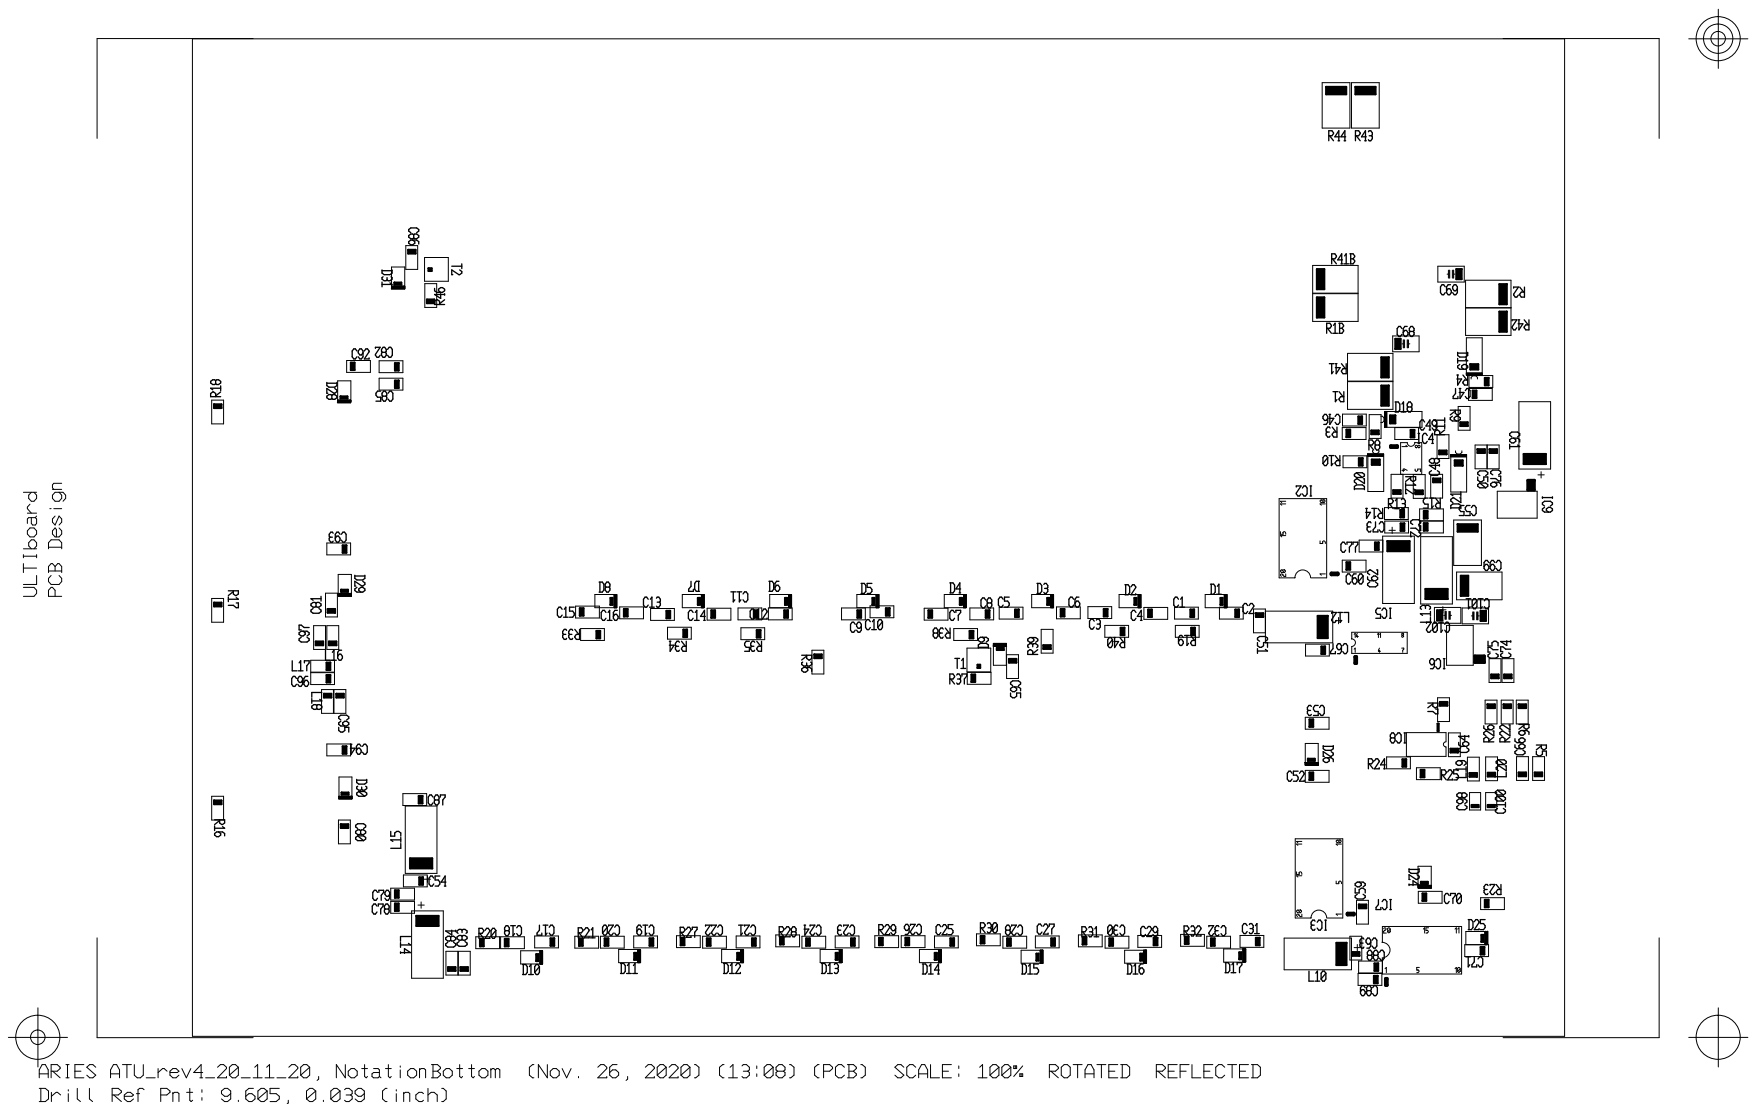
[picture p36: page 1]
