laurencebarker/Aries-ATU/hardware/rev 4/Aries Notation Top.pdf

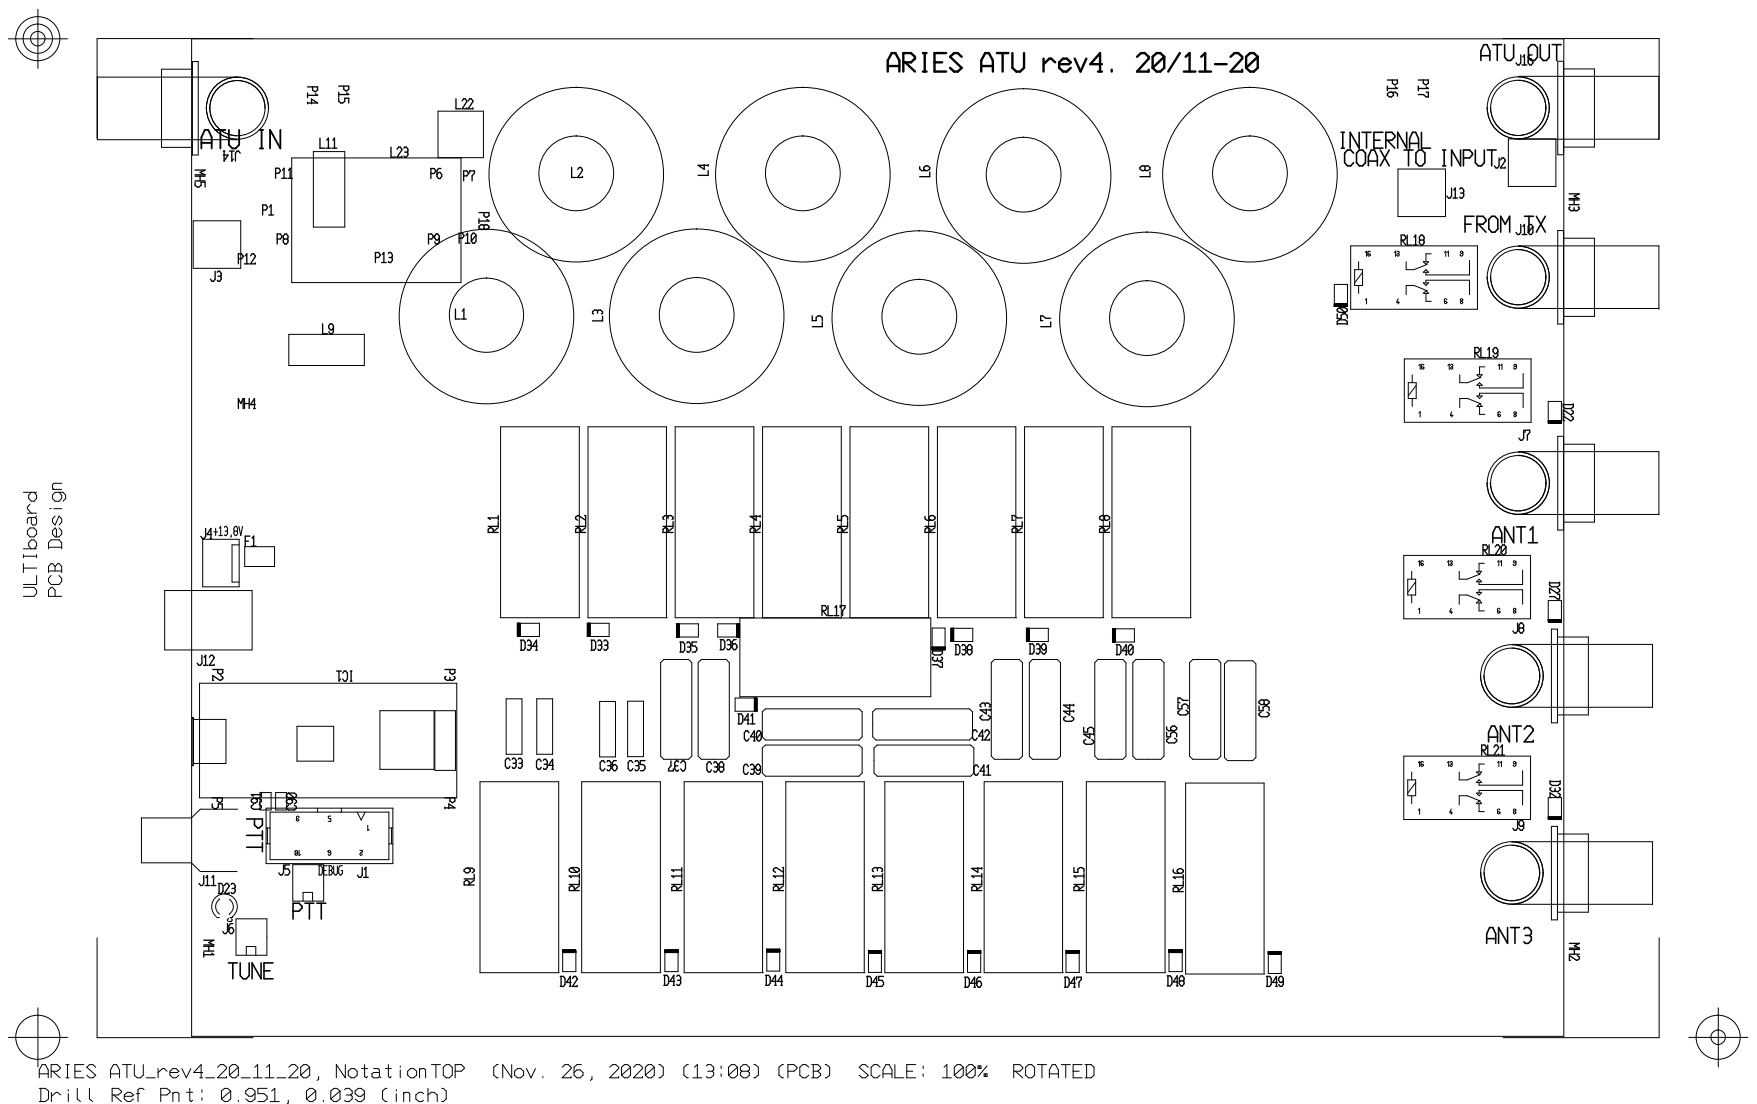
[picture p37: page 1]
