laurencebarker/Aries-ATU/hardware/rev 4/Aries_ATU_18_11_20.pdf

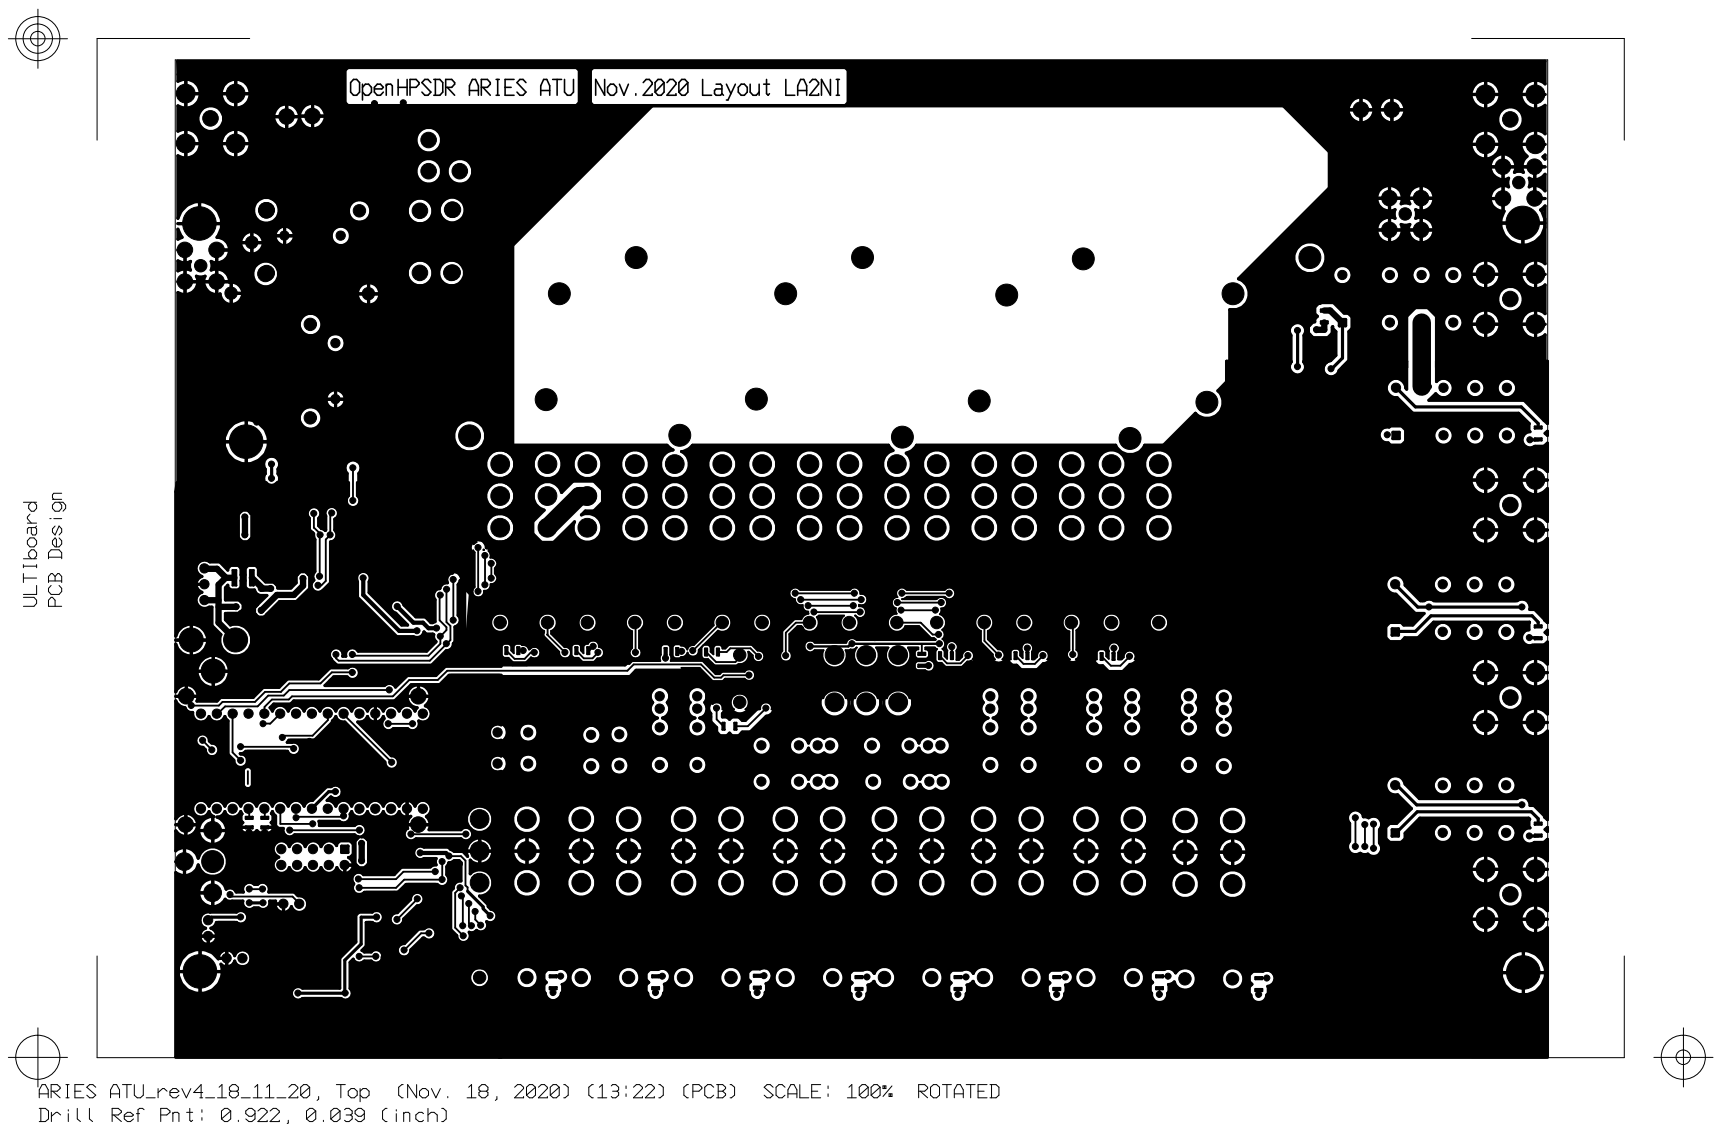
[picture p38: page 1]
