laurencebarker/Aries-ATU/hardware/rev 4/Aries_ATU_18_11_20_2.pdf

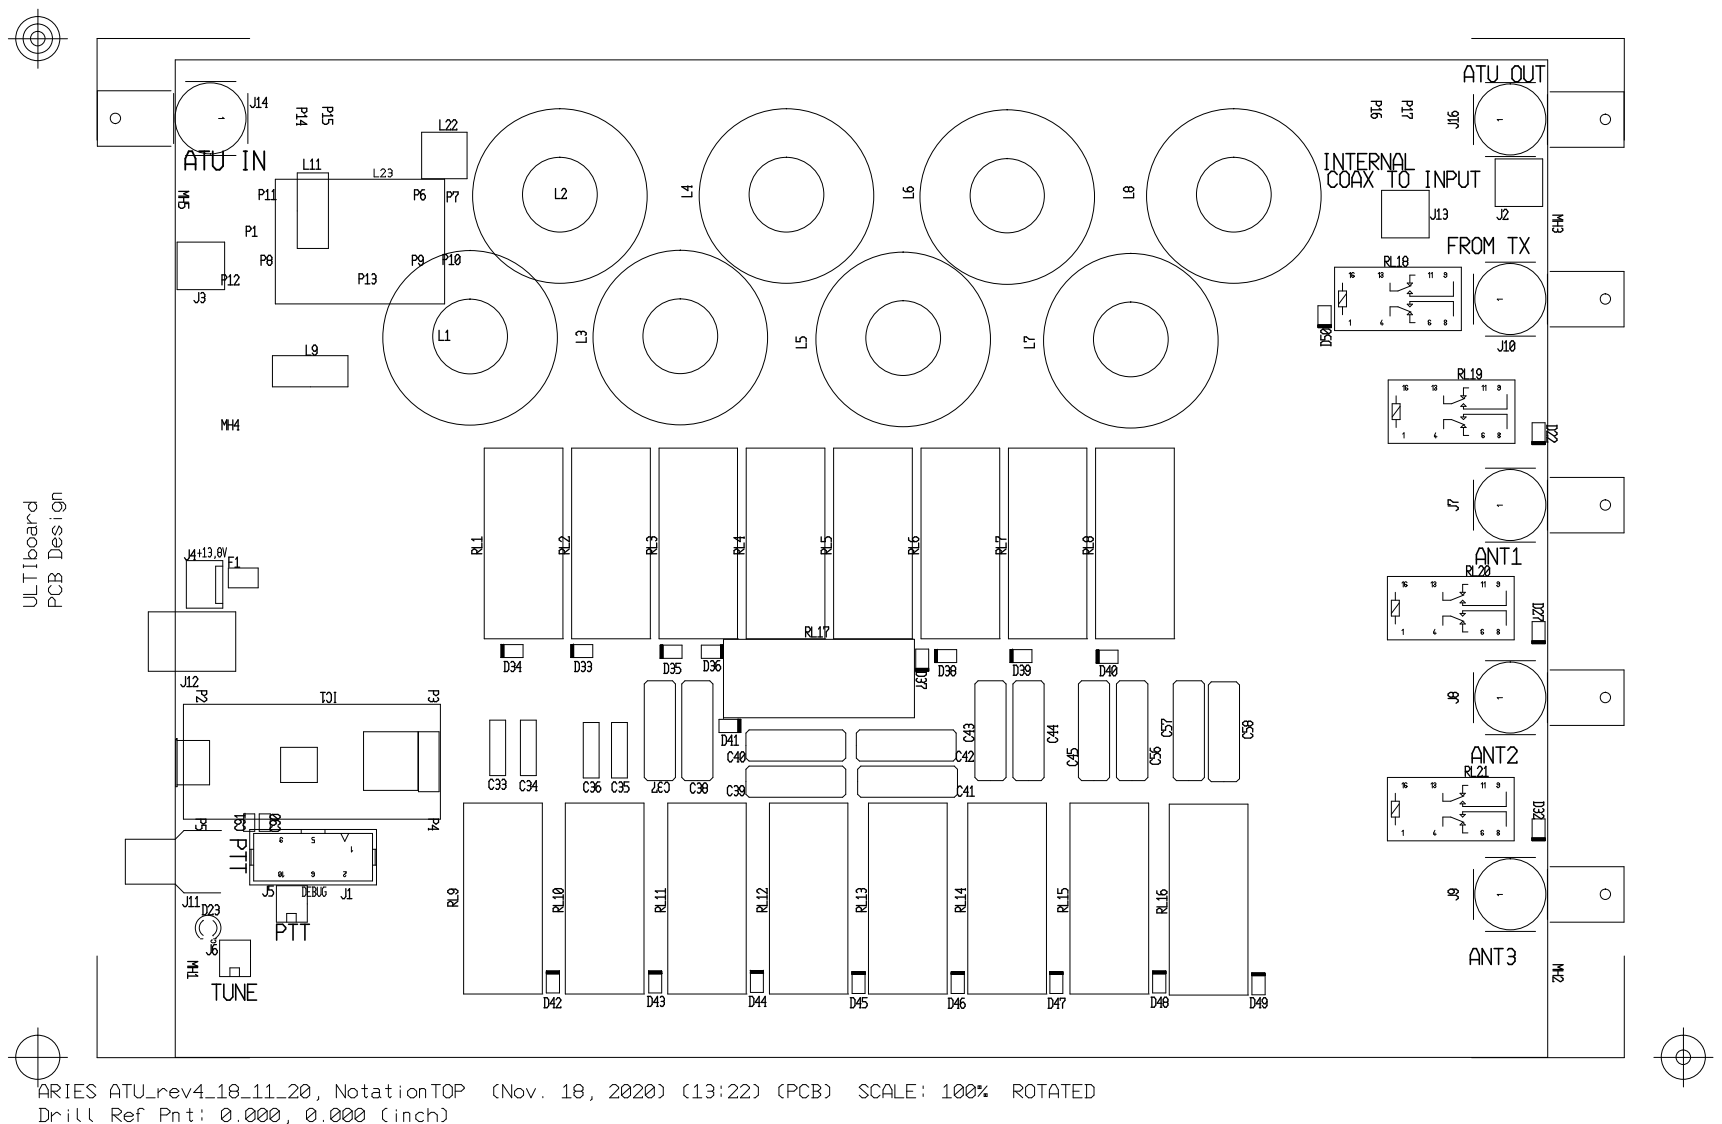
[picture p39: page 1]
