laurencebarker/Aries-ATU/hardware/rev 4/Aries_ATU_18_11_20_3.pdf

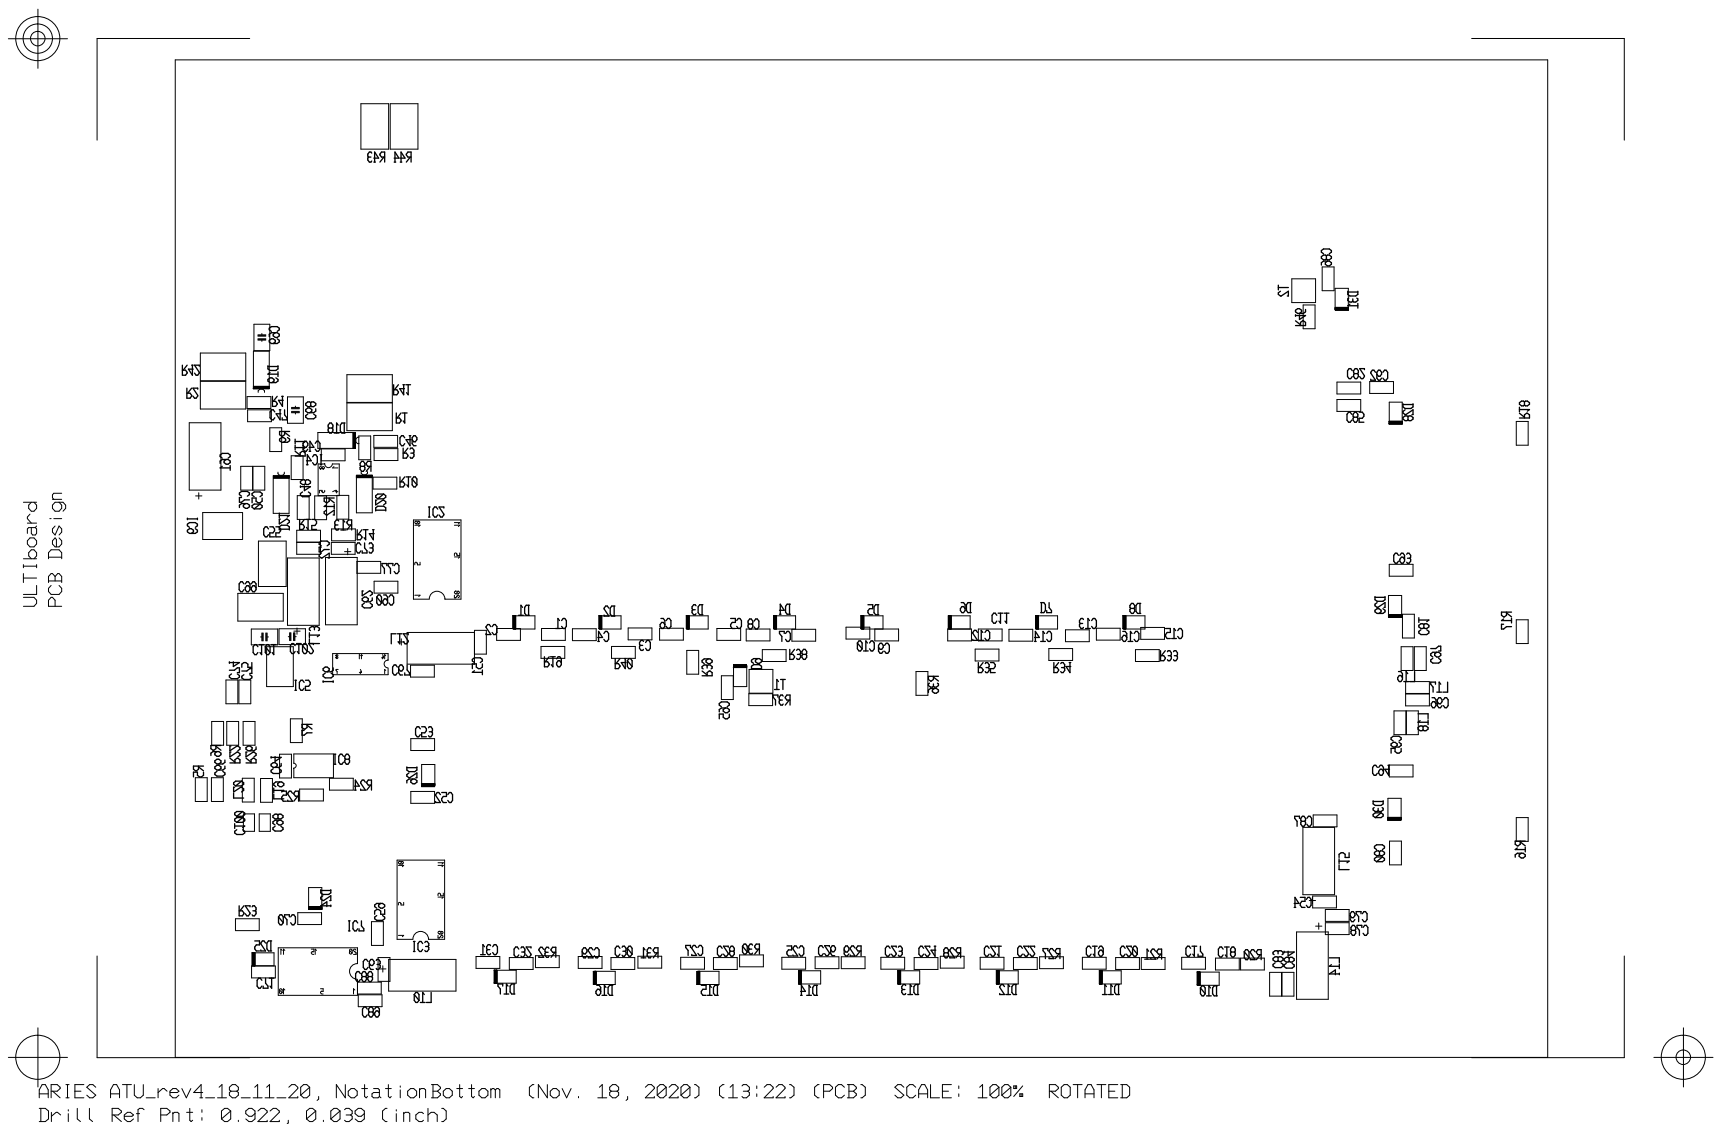
[picture p40: page 1]
