laurencebarker/Aries-ATU/hardware/rev 4/Aries_ATU_18_11_20_4.pdf

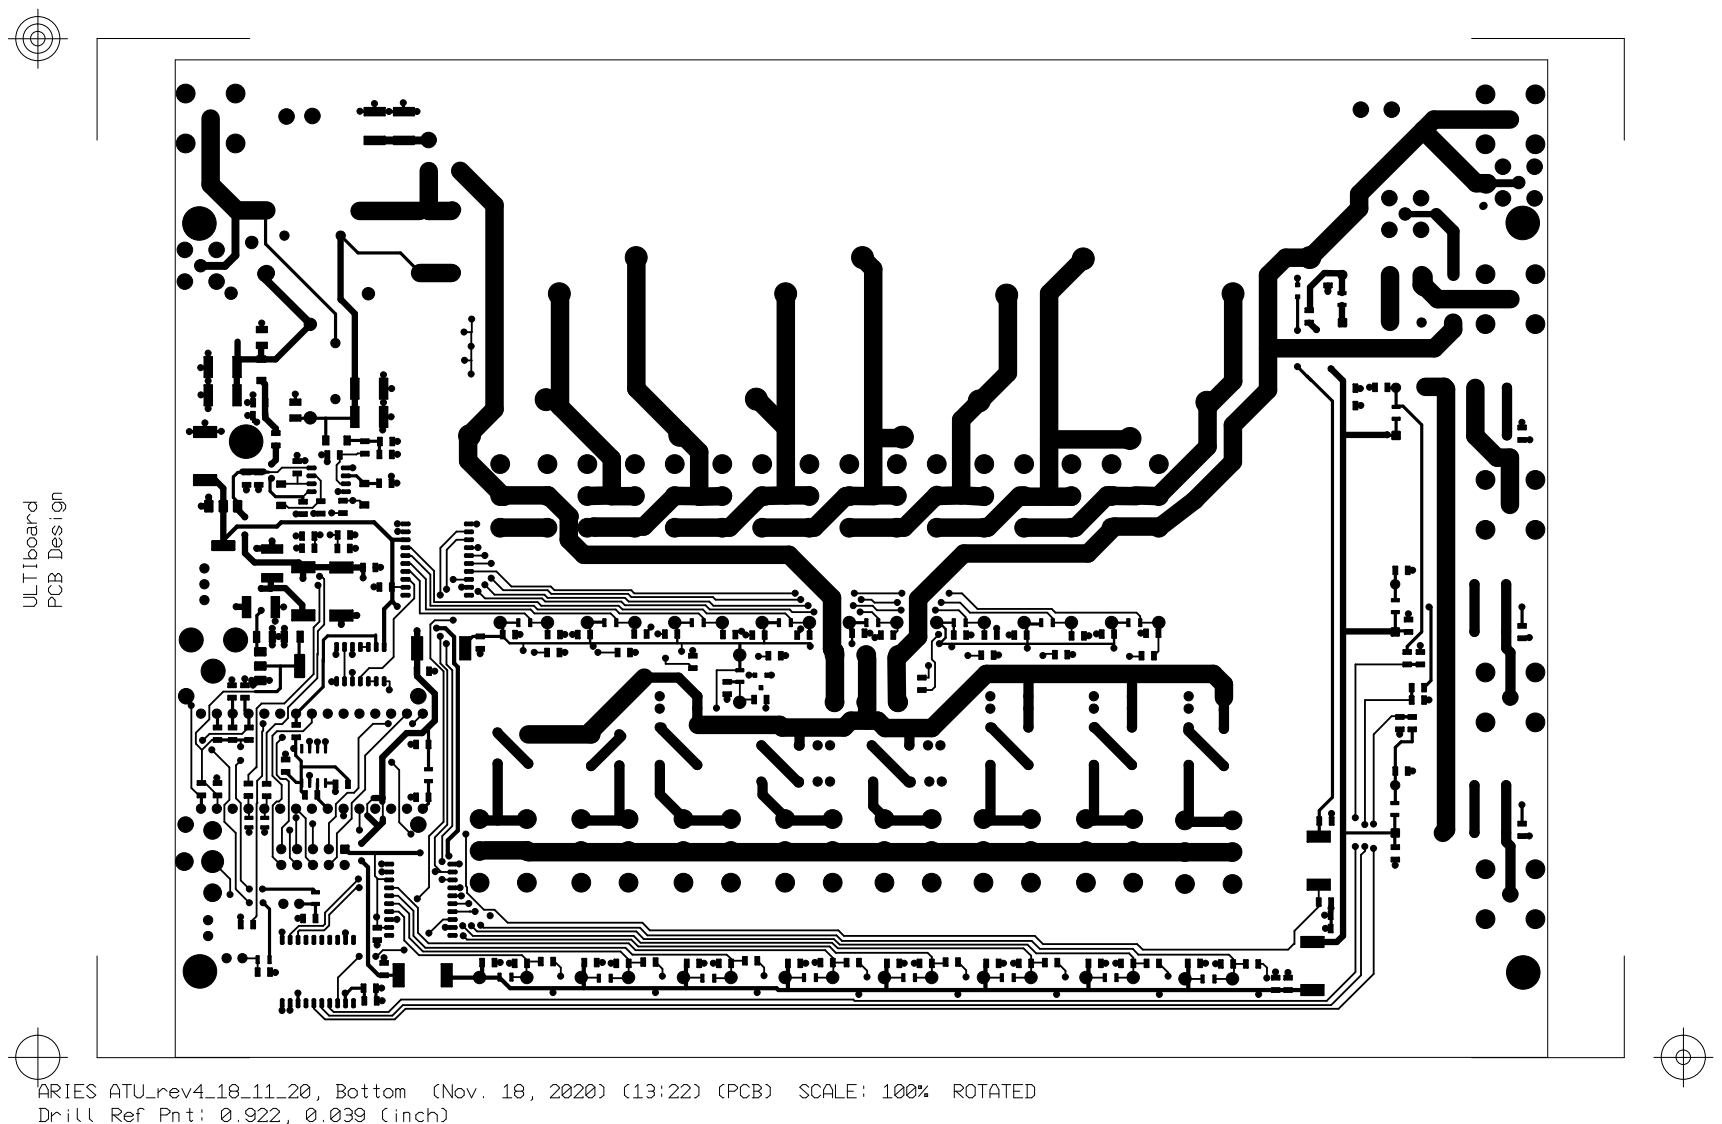
[picture p41: page 1]
