laurencebarker/Aries-ATU/hardware/rev2/ARIES ATU_rev4_19_05_20.pdf

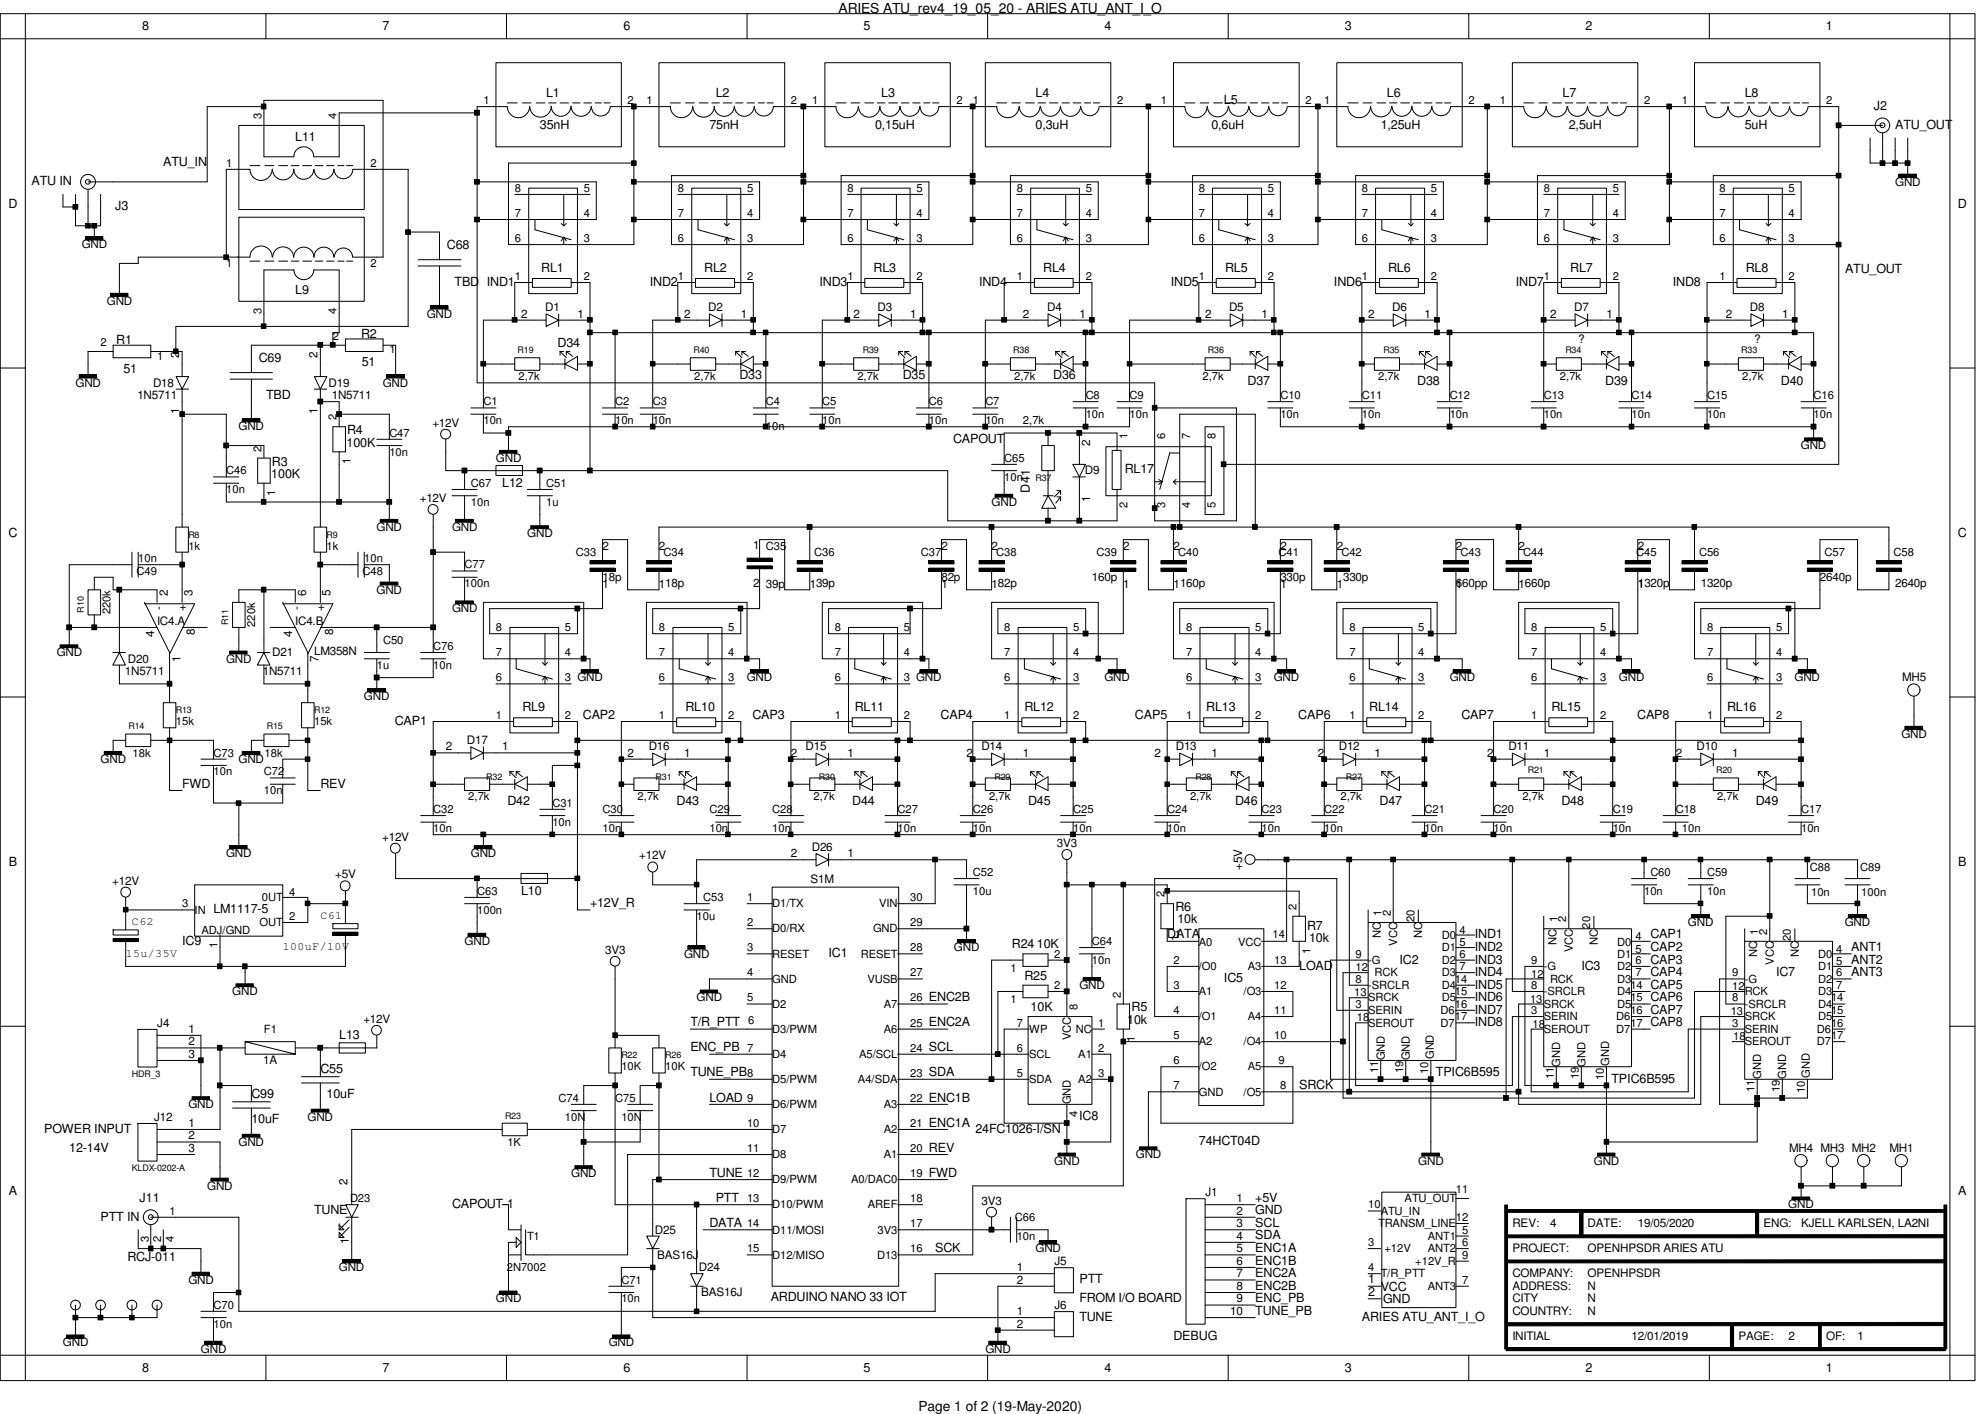
[picture p42: page 1]

CAPOUT-1 TUNE PTT IN

INITIAL 12/01/2019 | PAGE: 2 | OF: 1

# ARIES ATU_rev4_19_05_20 - ARIES ATU_ANT_I_O

D | D

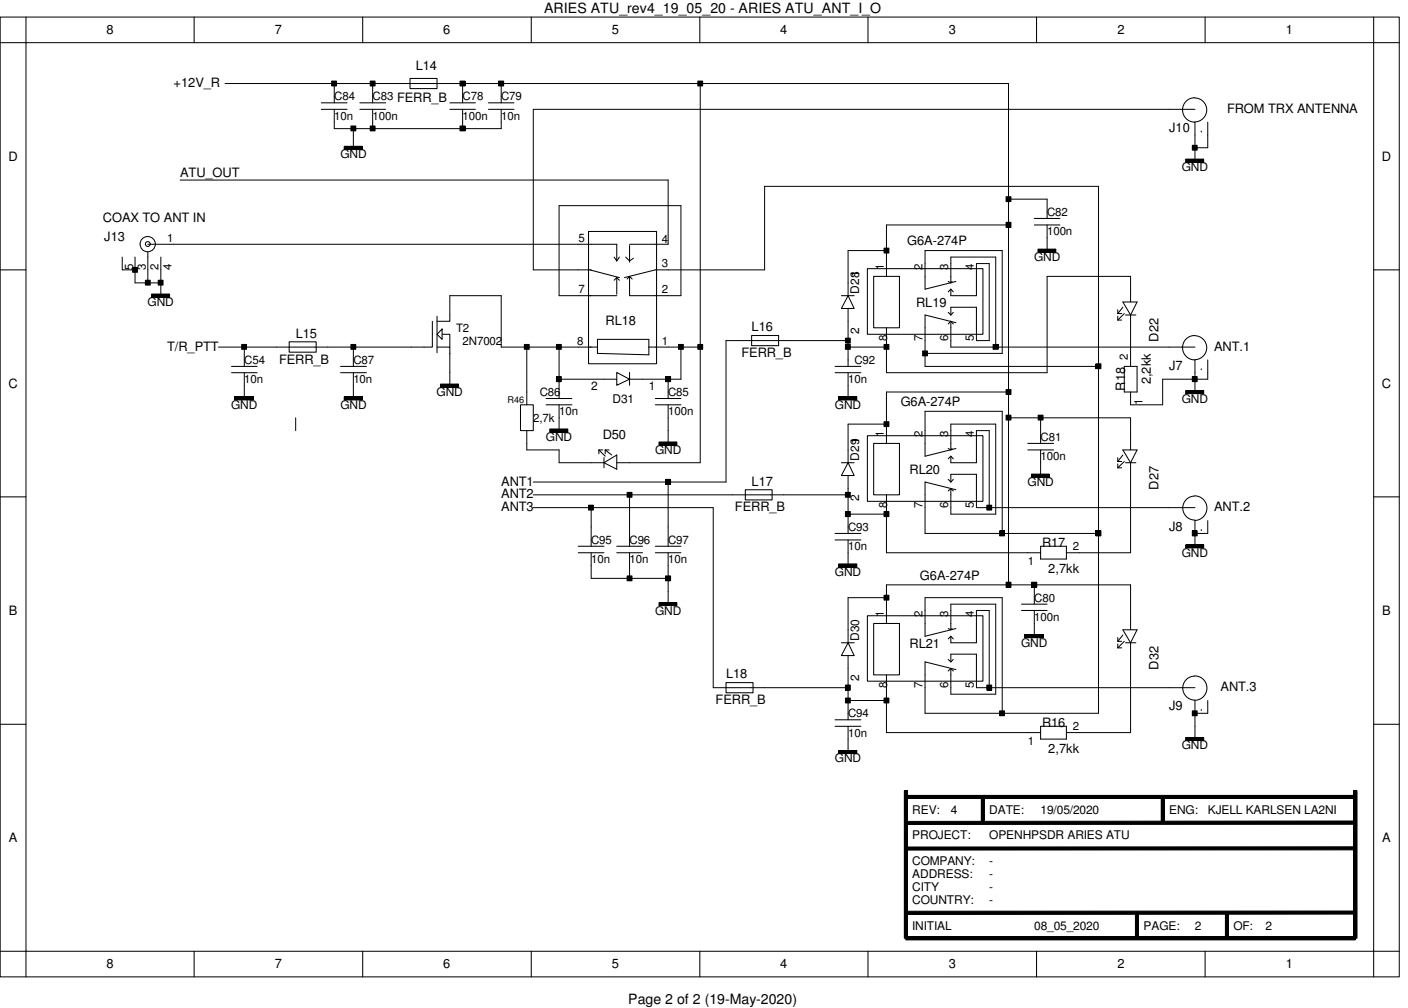
[picture p43: page 2]

COAX TO ANT IN
