laurencebarker/Aries-ATU/hardware/rev 1/OpenHPSDR ARIES ATU (003).pdf

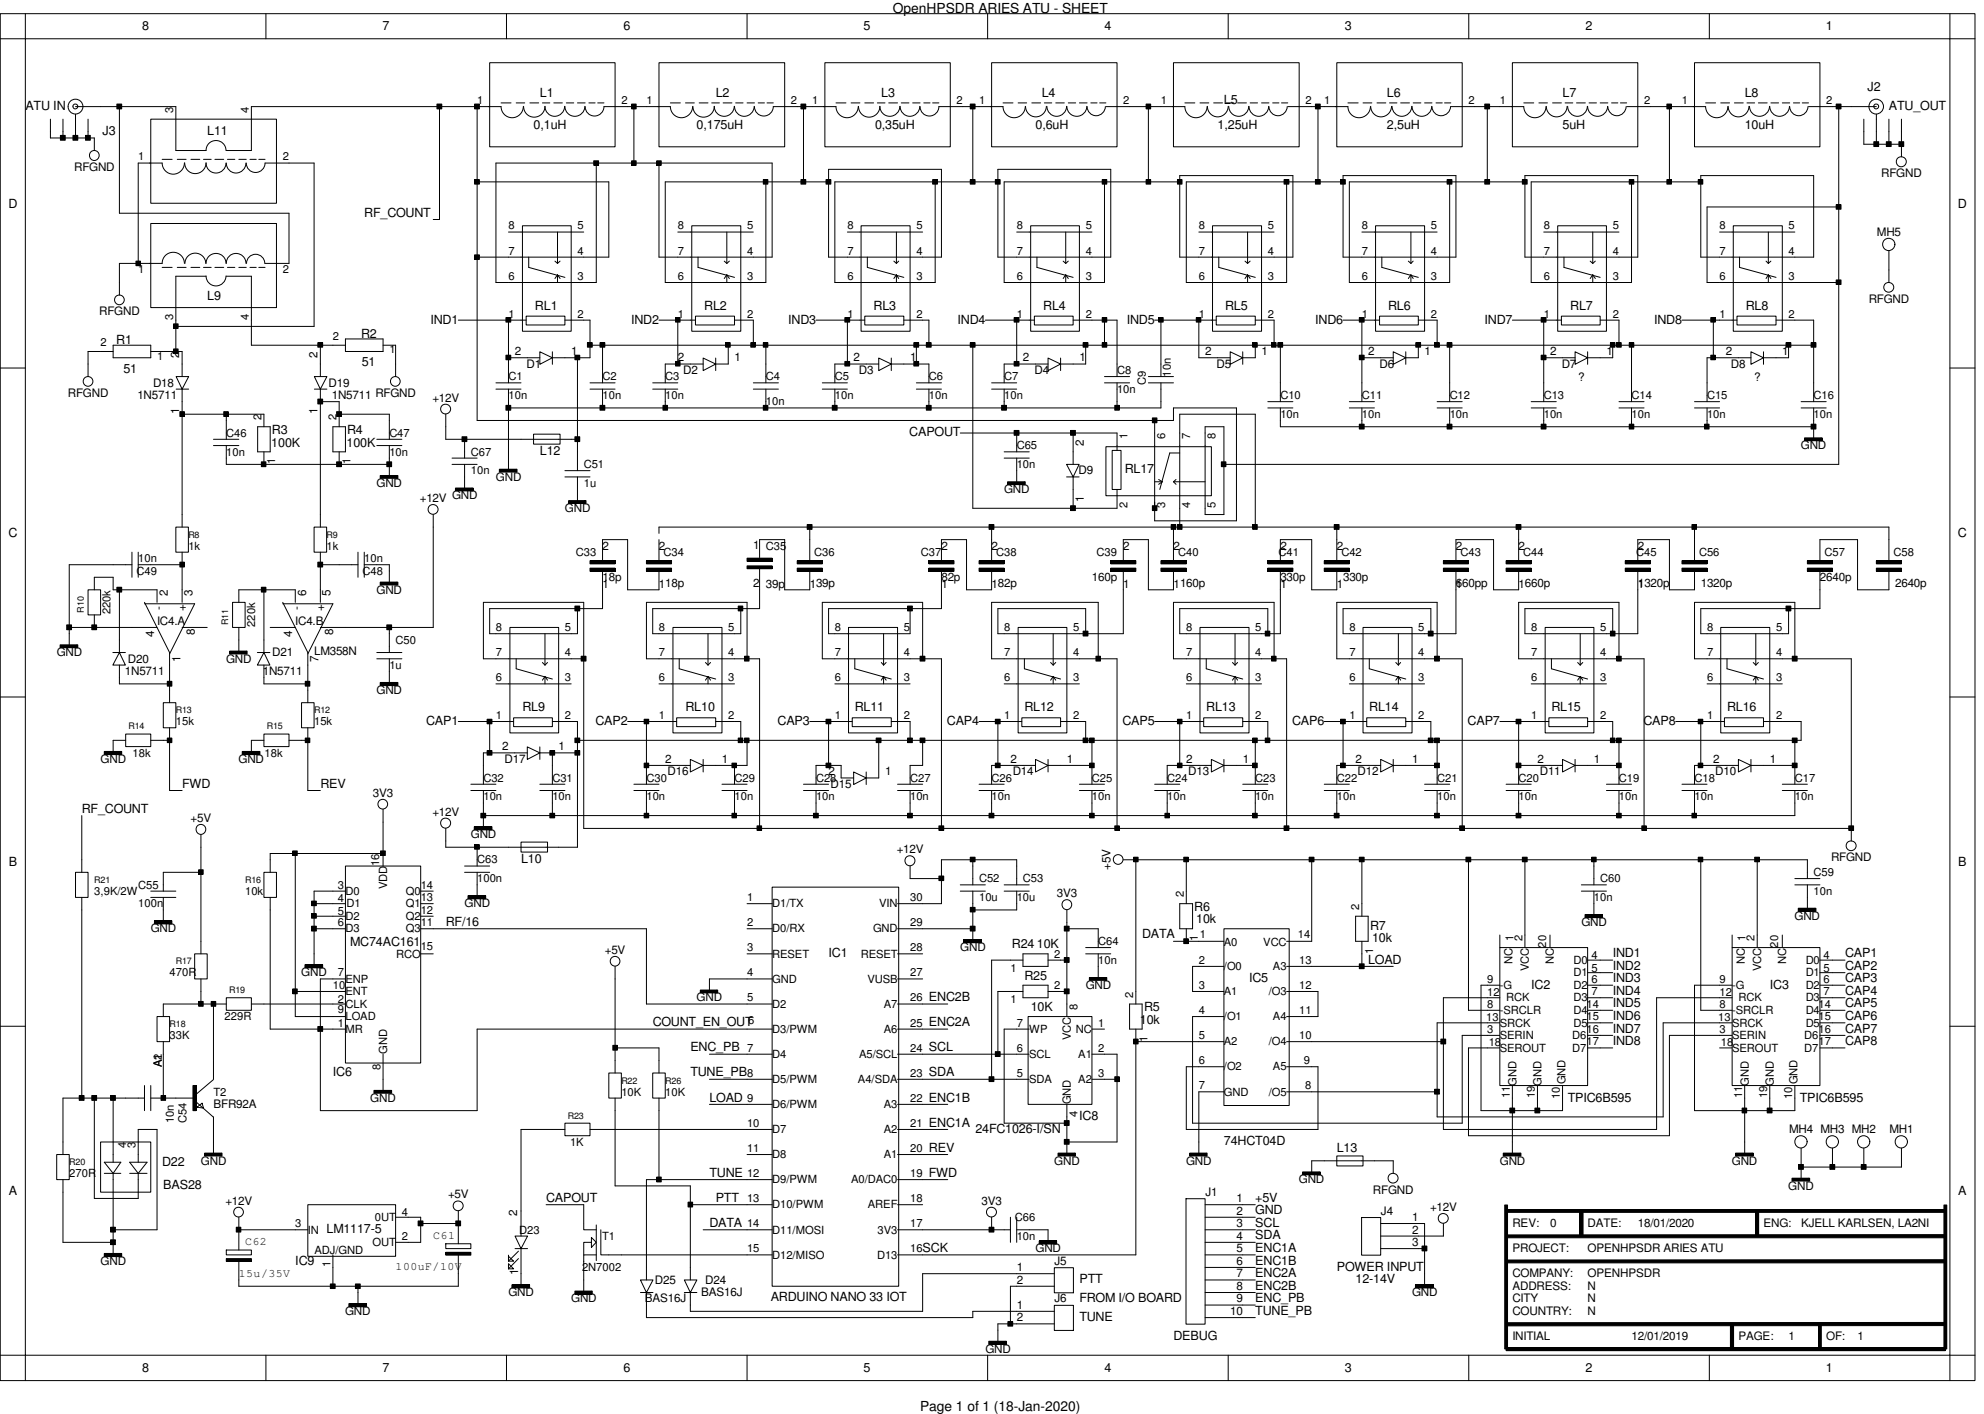
[picture p44: page 1]

OpenHPSDR ARIES ATU - SHEET
