laurencebarker/Aries-ATU/hardware/rev 1/OpenHPSDR ARIES ATU.pdf

OpenHPSDR ARIES ATU - SHEET
