laurencebarker/Aries-ATU/sketch/aries_sketch/aries_sketch.ino

/////////////////////////////////////////////////////////////////////////
//
// Aries ATU controller sketch by Laurence Barker G8NJJ
// this sketch controls an L-match ATU network
// with a CAT interface to connect to an HPSDR control program
// copyright (c) Laurence Barker G8NJJ 2019
//
// the code is written for an Arduino Nano 33 IoT module
//
// "main" file with setup() and loop()
// 2ms timer tick driven for real time operation
/////////////////////////////////////////////////////////////////////////
//
#include <Arduino.h>
#include <Wire.h>
#include "globalinclude.h"
#include "iopins.h"
#include "LCD_UI.h"
#include "hwdriver.h"
#include "algorithm.h"
#include "tiger.h"
#include "cathandler.h"
#include "protect.h"
#include <ZeroTimer.h>


//
// global variables
//
// for heartbeat LED:
bool ledOn = false;                         // true if status LED is lit
byte Counter = 0;                           // tick counter for LED on/off

int GTickCounter;                           // tick counter for 16ms tick

bool GTickTriggered;                        // true if a 16ms tick has been triggered
#define VMAINTICKSPERTIMERTICK 8            // 8 counts of 2ms per 16ms main tick


void setup() 
{
//
// configure I/O pins
//
  ConfigIOPins();
  delay(1000);                        // wait 1s, in case of a race for the Nextion display to be ready
//
// read the standalone mode jumper.
// if input LOW, jumper is inserted and we are in standalone mode.
// this pin is also the SPI MISO pin, but works for digital in. 
//
  if(HWVERSION >= 5)
  {
    if(digitalRead(VPINSTANDALONEJUMPER) == HIGH)
      GStandaloneMode = false;
    else
      GStandaloneMode = true;
  }
  else
    GStandaloneMode = false;

  
  Serial.begin(9600);               // PC communication
//
// removed the "wait for serial before starting" if standalone
//
  if(!GStandaloneMode)
  {
    while (!Serial)                   // wait for it to be ready 
    {
      ;
    }
  }
//
// initialise hardware drivers (relays etc)
//
  InitialiseHardwareDrivers();
  Wire.begin();                       // I2C
  Wire.setClock(400000);              // slow to 400KHz for external amp protect board
//
// initialise amplifier proection. This detects whether the MCP23017 is present
//
  InitProtection();
//
// initialise algorithm
//
  InitialiseAlgorithm();
//
// initialise CAT handler
//
  InitCAT();
  InitCATHandler();

//
//
// initialise UI
//
  LCD_UI_Initialise();

//
// initialise timer to give 2ms tick interrupt
//
  TC.startTimer(2000, TickHandler);             // 2ms tick: timer period is in microseconds
}


//
// ZeroTimer interrupt handler
// called every 2ms; invole main tick code every 8 ticks
// light touch encoder scan every 2ms, and do a different encoder each tick
//
void TickHandler(void)
{
  bool IsOdd = false;                           // call encoder tick with alternating odd/even setting
  if(GTickCounter &1)
    IsOdd = true;

  LCD_UI_EncoderTick(IsOdd);

//
// now count ticks to 16ms tick
//
  if(GTickCounter == 0)
  {
    GTickCounter = VMAINTICKSPERTIMERTICK-1;
    GTickTriggered = true;
  }
  else
    GTickCounter--;
}



//
// 16 ms event loop
// this is triggered by GTickTriggered being set by a timer interrupt
// the loop simply waits until released by the timer handler
void loop()
{
  while (GTickTriggered)
  {
    GTickTriggered = false;
// heartbeat LED
    if (Counter == 0)
    {
      Counter=31;
      ledOn = !ledOn;
      if (ledOn)
        digitalWrite(VPINBLINKLED, HIGH); // Led on, off, on, off...
      else
        digitalWrite(VPINBLINKLED, LOW);
    }
    else
      Counter--;

//
// look for any CAT commands in the serial input buffer and process them
//    
    ScanParseSerial();

//
// read VSWR, then algorithm tick
// algorithm tick throttles its operating speed to allow relays to settle
//
    HWDriverTick();
    AlgorithmTick();

//
// THETIS interface tick
//
    CatHandlerTick();

// 
// amplifier protection, if included
//
    if(GProtectionPresent)
      ProtectionTick();
    
//
// UI tick
//
    LCD_UI_Tick();
  }   // while loop
}



//
// set pinmode for all I/O pins used
// and write any output initial states
//
void ConfigIOPins(void)
{
  pinMode(LED_BUILTIN, OUTPUT);
  pinMode(VPINENCODER1A, INPUT_PULLUP);                 // normal encoder
  pinMode(VPINENCODER1B, INPUT_PULLUP);                 // normal encoder
  pinMode(VPINENCODER1PB, INPUT_PULLUP);                // normal pushbutton

  pinMode(VPINTR_PTTOUT, OUTPUT);
  pinMode(VPINSERIALLOAD, OUTPUT);                      // serial data latch o/p
  pinMode(VPINPTT, INPUT_PULLUP);                       // PTT input
  pinMode(VPINBLINKLED, OUTPUT);                        // status LED (normal D13 ise used for SPI)
  pinMode(VPINTUNELED, OUTPUT);                         // tune LED (lit if good tune solution)

  pinMode(VPINHWTUNECMD, INPUT_PULLUP);                 // hardwired TUNE command input
  pinMode(VPINSTANDALONEJUMPER, INPUT_PULLUP);          // jumper input for STANDALONE
  pinMode(VPINSTANDALONEANTA, INPUT_PULLUP);            // wired input for antenna select
  pinMode(VPINSTANDALONEANTB, INPUT_PULLUP);            // wired input for antenna select

  if(HWVERSION >= 5)
    pinMode(VPINPROTECTIONTRIP, INPUT_PULLUP);            // protection trip i/p (hw rev 5+)
  else
  {
    pinMode(VPINRELAYLOHIZ, OUTPUT);                      // relay o/p
    digitalWrite(VPINRELAYLOHIZ, LOW);                    // deactivate relay
  }
  digitalWrite(VPINTR_PTTOUT, LOW);                     // deactivate T/R output

// PTT interrupt needs to catch both edges so we can send SPI data for T/R relay and RX/TX antenna
  attachInterrupt(VPINPTT, PttISR, FALLING);
  
// h/w tune interrupt needs to catch falling edge to initiate a tune request.
  attachInterrupt(VPINHWTUNECMD, HWTuneISR, FALLING);

}
