laurencebarker/Aries-ATU/(commit log)

2019-10-30 Initial commit of development files
    [aries eeprom calculator.xlsx, atu toroids.xlsx, inductance and capacitance calculator.xlsx, series capacitor calculator.xlsx, test loads.xlsx]
2019-11-18 updates mic nov
    [stockton bridge calculator.xls]
2020-02-19 updated code with Thetis interface
    [Aries parts list.xlsx, aries eeprom access time calculator.xlsx, aries memory calculator.xlsx, stockton bridge calculator.xls]
2020-03-02 updated description of setting up Arduino environment
2020-03-24 VSWR bridge testing
    [24032020 vswr bridge.xlsx, Aries parts list.xlsx, stockton bridge calculator.xls]
2020-03-26 slightly better VSWR debug
    [24032020 vswr bridge.xlsx]
2020-03-29 post VSWR bridge tests
    VSWR measurements at 50MHz still affected
    [24032020 vswr bridge.xlsx]
2020-04-05 Thetis integration for tuning algorithm
    Numerous small changes to make the algorithm interface to Thetis
    [24032020 vswr bridge.xlsx, atu toroids.xlsx]
2020-04-11 new tuning algorithm
    [24032020 vswr bridge.xlsx, atu toroids.xlsx]
2020-07-01 schematic update
    [24032020 vswr bridge.xlsx]
2020-12-07 Rev 4 hardware; code changes to integrate better to thetis
    [16112020 Aries mk2 tuning solutions.xlsx, 24032020 Aries mk1 test results.xlsx, Aries parts list rev 2.xlsx, Aries parts list rev 4.xlsx, atu toroids.xlsx, stockton bridge calculator BN43_3312.xls, stockton bridge calculator FT50_61.xls, stockton bridge calculator.xls]
2020-12-16 updated the #defines for nextion display
    [Aries parts list rev 4.xlsx]
2020-12-17 error in tune table for 7MHz
    [algorithm.cpp]
2021-01-08 minor update
    Always disables ATU (set L=C=0) immediately when set to disabled
    fix issue to only update relays in RX mode if antenna value different from that asserted to hardware.
    [cathandler.cpp, hwdriver.cpp]
2021-01-22 standalone capability and display added
    This is after the display crash was fixed. Set_font_color_pco() seems to have caused the display to lock up somehow. Symptoms: doesn't respond to normal updates, and much slower operation stalling the normal 16ms tick by 2-3x.
    [stockton bridge calculator BN43_3312.xls]
2021-01-22 further standalone code
    display scale storage added;
    separate ADC scale factors for each scale;
    single debug encoder;
    antenna change only sends ZZOX if enabled
    [stockton bridge calculator BN43_3312.xls]
2021-01-22 Added setup page for standalone use
    [stockton bridge calculator BN43_3312.xls]
2021-04-09 hw v5 update
    [Aries parts list rev 5.xlsx, protection board parts list.xlsx, stockton bridge calculator BN43_3312.xls]
2021-04-18 rev 5 normal mode completed. not standalone yet.
    [16112020 Aries mk2 tuning solutions.xlsx, Aries parts list rev 5.xlsx]
2022-10-13 added tune LED as DIG7; blink on A7
    [stockton bridge calculator BN43_3312.xls]
2022-10-13 changed to correct LED for tune!
    [cathandler.cpp]
2022-10-13 updated again to get LED drive correct!
    [cathandler.cpp, iopins.h]
